hyperswine/simple-risc/docs/evidence/2026-11-07-refactor/haskell-tests.txt

Resolving dependencies...
Build profile: -w ghc-9.8.2 -O1
In order, the following will be built (use -v for more details):
 - simple-risc-0.1.0.0 (lib) (configuration changed)
 - simple-risc-0.1.0.0 (test:simple-risc-test) (configuration changed)
Configuring library for simple-risc-0.1.0.0...
Preprocessing library for simple-risc-0.1.0.0...
Building library for simple-risc-0.1.0.0...
[4 of 9] Compiling SimpleRisc.Decode ( src/SimpleRisc/Decode.hs, dist-newstyle/build/aarch64-osx/ghc-9.8.2/simple-risc-0.1.0.0/build/SimpleRisc/Decode.o, dist-newstyle/build/aarch64-osx/ghc-9.8.2/simple-risc-0.1.0.0/build/SimpleRisc/Decode.dyn_o ) [Source file changed]
[6 of 9] Compiling SimpleRisc       ( src/SimpleRisc.hs, dist-newstyle/build/aarch64-osx/ghc-9.8.2/simple-risc-0.1.0.0/build/SimpleRisc.o, dist-newstyle/build/aarch64-osx/ghc-9.8.2/simple-risc-0.1.0.0/build/SimpleRisc.dyn_o ) [Source file changed]

src/SimpleRisc.hs:557:16: warning: [GHC-30606] [-Wredundant-constraints]
    Redundant constraint: 1 <= n
    In the type signature for:
         initialFifo :: forall (n :: Nat).
                        (KnownNat n, KnownNat (n + 1), 1 <= n) =>
                        Fifo n
    |
557 | initialFifo :: (KnownNat n, KnownNat (n + 1), 1 <= n) => Fifo n
    |                ^^^^^^^^^^^^^^^^^^^^^^^^^^^^^^^^^^^^^^

src/SimpleRisc.hs:674:13: warning: [GHC-63397] [-Wname-shadowing]
    This binding for ‘at’ shadows the existing binding
      imported from ‘Clash.Prelude’ at src/SimpleRisc.hs:80:1-20
      (and originally defined in ‘Clash.Sized.Vector’)
    |
674 |     writing at = case taken of
    |             ^^

src/SimpleRisc.hs:2570:7: warning: [GHC-40910] [-Wunused-local-binds]
    Defined but not used: ‘instruction’
     |
2570 |   let instruction = cpuInstruction machine
     |       ^^^^^^^^^^^
[7 of 9] Compiling SdramSimpleRisc  ( src/SdramSimpleRisc.hs, dist-newstyle/build/aarch64-osx/ghc-9.8.2/simple-risc-0.1.0.0/build/SdramSimpleRisc.o, dist-newstyle/build/aarch64-osx/ghc-9.8.2/simple-risc-0.1.0.0/build/SdramSimpleRisc.dyn_o ) [SimpleRisc changed]
[8 of 9] Compiling SdramPipeline    ( src/SdramPipeline.hs, dist-newstyle/build/aarch64-osx/ghc-9.8.2/simple-risc-0.1.0.0/build/SdramPipeline.o, dist-newstyle/build/aarch64-osx/ghc-9.8.2/simple-risc-0.1.0.0/build/SdramPipeline.dyn_o ) [SimpleRisc changed]

src/SdramPipeline.hs:83:14: warning: [GHC-40910] [-Wunused-local-binds]
    Defined but not used: ‘index’
   |
83 |       (next,(index,write,tx),stages,loads)=R.machineStepCoreStagesBy R.pipelinedCpuStepStages decodeTarget injected (memoryWord,received,txReady,emergency)
   |              ^^^^^

src/SdramPipeline.hs:119:10: warning: [GHC-63397] [-Wname-shadowing]
    This binding for ‘at’ shadows the existing binding
      imported from ‘Clash.Prelude’ at src/SdramPipeline.hs:4:1-20
      (and originally defined in ‘Clash.Sized.Vector’)
    |
119 |  writing at=case taken of
    |          ^^
[9 of 9] Compiling SdramPipelineObserved ( src/SdramPipelineObserved.hs, dist-newstyle/build/aarch64-osx/ghc-9.8.2/simple-risc-0.1.0.0/build/SdramPipelineObserved.o, dist-newstyle/build/aarch64-osx/ghc-9.8.2/simple-risc-0.1.0.0/build/SdramPipelineObserved.dyn_o ) [SimpleRisc changed]
Configuring test suite 'simple-risc-test' for simple-risc-0.1.0.0...
Preprocessing test suite 'simple-risc-test' for simple-risc-0.1.0.0...
Building test suite 'simple-risc-test' for simple-risc-0.1.0.0...
[1 of 5] Compiling FQueueVariant    ( test/FQueueVariant.hs, dist-newstyle/build/aarch64-osx/ghc-9.8.2/simple-risc-0.1.0.0/t/simple-risc-test/build/simple-risc-test/simple-risc-test-tmp/FQueueVariant.o ) [SimpleRisc changed]

test/FQueueVariant.hs:25:2: warning: [GHC-63397] [-Wname-shadowing]
    This binding for ‘empty’ shadows the existing binding
      imported from ‘Clash.Prelude’ at test/FQueueVariant.hs:7:1-20
      (and originally defined in ‘GHC.Base’)
   |
25 |  empty = R.Fetched 0 0 False False 0 0 4
   |  ^^^^^
[4 of 5] Compiling SimpleRisc       ( test/SimpleRisc.hs, dist-newstyle/build/aarch64-osx/ghc-9.8.2/simple-risc-0.1.0.0/t/simple-risc-test/build/simple-risc-test/simple-risc-test-tmp/SimpleRisc.o ) [Source file changed]

test/SimpleRisc.hs:1032:7: warning: [GHC-63397] [-Wname-shadowing]
    This binding for ‘settled’ shadows the existing binding
      defined at test/SimpleRisc.hs:107:1
     |
1032 |       settled = stepDevices False False NoEffect (stepDevices False False NoEffect devices)
     |       ^^^^^^^

test/SimpleRisc.hs:1066:3: warning: [GHC-63397] [-Wname-shadowing]
    This binding for ‘delay’ shadows the existing binding
      imported from ‘Clash.Prelude’ at test/SimpleRisc.hs:17:1-38
      (and originally defined in ‘Clash.Signal’)
     |
1066 |   delay <- forAll (Gen.integral (Range.linear 200 400))
     |   ^^^^^

test/SimpleRisc.hs:1112:18: warning: [GHC-63394] [-Wx-partial]
    In the use of ‘head’
    (imported from Prelude, but defined in GHC.List):
    "This is a partial function, it throws an error on empty lists. Use pattern matching or Data.List.uncons instead. Consider refactoring to use Data.List.NonEmpty."
     |
1112 |       fetching = P.head (P.dropWhile ((/= Fetch) . cpuPhase) (P.iterate step m))
     |                  ^^^^^^

test/SimpleRisc.hs:1118:21: warning: [GHC-63394] [-Wx-partial]
    In the use of ‘head’
    (imported from Prelude, but defined in GHC.List):
    "This is a partial function, it throws an error on empty lists. Use pattern matching or Data.List.uncons instead. Consider refactoring to use Data.List.NonEmpty."
     |
1118 |       let entered = P.head (P.dropWhile ((== Trap) . cpuPhase) (P.iterate step next))
     |                     ^^^^^^

test/SimpleRisc.hs:1152:15: warning: [GHC-63397] [-Wname-shadowing]
    This binding for ‘at’ shadows the existing binding
      imported from ‘Clash.Prelude’ at test/SimpleRisc.hs:17:1-38
      (and originally defined in ‘Clash.Sized.Vector’)
     |
1152 |   let request at wr value = Just (BusRequest (ioBase+at) 2 wr value)
     |               ^^

test/SimpleRisc.hs:1153:25: warning: [GHC-63397] [-Wname-shadowing]
    This binding for ‘reset’ shadows the existing binding
      bound at test/SimpleRisc.hs:1159:7
     |
1153 |       clock io req held reset = fst (SP.spiIoStep io (req,reset,held,high))
     |                         ^^^^^

test/SimpleRisc.hs:1184:15: warning: [GHC-63397] [-Wname-shadowing]
    This binding for ‘rises’ shadows the existing binding
      bound at test/SimpleRisc.hs:1194:20
     |
1184 |       run spi rises sent fuel
     |               ^^^^^

test/SimpleRisc.hs:1184:21: warning: [GHC-63397] [-Wname-shadowing]
    This binding for ‘sent’ shadows the existing binding
      bound at test/SimpleRisc.hs:1194:14
     |
1184 |       run spi rises sent fuel
     |                     ^^^^

test/SimpleRisc.hs:1245:23: warning: [GHC-40910] [-Wunused-local-binds]
    Defined but not used: ‘sck’
     |
1245 |       (io', (answer, (sck, mosi, _), ramCommand)) = ioStep io (request, False, misoBit, rigRamOut rig)
     |                       ^^^

test/SimpleRisc.hs:1300:16: warning: [GHC-63394] [-Wx-partial]
    In the use of ‘head’
    (imported from Prelude, but defined in GHC.List):
    "This is a partial function, it throws an error on empty lists. Use pattern matching or Data.List.uncons instead. Consider refactoring to use Data.List.NonEmpty."
     |
1300 |       status = P.head (rigAnswers (rigAccess ioDmaStatus False 0 received))
     |                ^^^^^^

test/SimpleRisc.hs:1310:17: warning: [GHC-63394] [-Wx-partial]
    In the use of ‘head’
    (imported from Prelude, but defined in GHC.List):
    "This is a partial function, it throws an error on empty lists. Use pattern matching or Data.List.uncons instead. Consider refactoring to use Data.List.NonEmpty."
     |
1310 |       refusal = P.head (rigAnswers (rigAccess ioDmaStatus False 0 refused))
     |                 ^^^^^^

test/SimpleRisc.hs:1324:19: warning: [GHC-63397] [-Wname-shadowing]
    This binding for ‘io’ shadows the existing binding
      bound at test/SimpleRisc.hs:1331:17
     |
1324 |       go fuel sim io
     |                   ^^

test/SimpleRisc.hs:1385:16: warning: [GHC-63397] [-Wname-shadowing]
    This binding for ‘odd’ shadows the existing binding
      imported from ‘Clash.Prelude’ at test/SimpleRisc.hs:17:1-38
      (and originally defined in ‘Clash.Class.Parity’)
     |
1385 |     (8, (\f3 k odd rs1 rs2 -> [bType (4 * k + (if odd then 2 else 0)) rs2 rs1 f3 0])
     |                ^^^

test/SimpleRisc.hs:1391:13: warning: [GHC-63397] [-Wname-shadowing]
    This binding for ‘odd’ shadows the existing binding
      imported from ‘Clash.Prelude’ at test/SimpleRisc.hs:17:1-38
      (and originally defined in ‘Clash.Class.Parity’)
     |
1391 |     (3, (\k odd rd -> [(9 `shiftL` 7) .|. 0x17, iType (4 * (k + 1) + (if odd then 2 else 0)) 9 0 rd 0x67])
     |             ^^^

test/SimpleRisc.hs:1407:5: warning: [GHC-63397] [-Wname-shadowing]
    This binding for ‘forward’ shadows the existing binding
      imported from ‘Clash.Prelude’ at test/SimpleRisc.hs:17:1-38
      (and originally defined in ‘Clash.Signal.Delayed.Internal’)
     |
1407 |     forward = Gen.integral (Range.linear 1 remaining)
     |     ^^^^^^^

test/SimpleRisc.hs:1426:18: warning: [GHC-63397] [-Wname-shadowing]
    This binding for ‘at’ shadows the existing binding
      imported from ‘Clash.Prelude’ at test/SimpleRisc.hs:17:1-38
      (and originally defined in ‘Clash.Sized.Vector’)
     |
1426 |             from at c = do
     |                  ^^

test/SimpleRisc.hs:1482:21: warning: [GHC-18042] [-Wtype-defaults]
    • Defaulting the type variable ‘a0’ to type ‘Integer’ in the following constraints
        (Num a0) arising from the literal ‘1’ at test/SimpleRisc.hs:1482:21
        (Enum a0)
          arising from the arithmetic sequence ‘1 .. 8’
          at test/SimpleRisc.hs:1482:20-27
        (Integral a0)
          arising from a use of ‘fromIntegral’
          at test/SimpleRisc.hs:1485:58-69
        (Integral a0)
          arising from a use of ‘fromIntegral’
          at test/SimpleRisc.hs:1490:80-91
    • In the expression: 1
      In the first argument of ‘P.zip’, namely ‘[1 .. 8]’
      In the first argument of ‘(P.++)’, namely ‘P.zip [1 .. 8] values’
     |
1482 |   let regs = P.zip [1 .. 8] values P.++ [(31, dataPointer)]
     |                     ^

test/SimpleRisc.hs:1543:21: warning: [GHC-18042] [-Wtype-defaults]
    • Defaulting the type variable ‘a0’ to type ‘Integer’ in the following constraints
        (Num a0) arising from the literal ‘1’ at test/SimpleRisc.hs:1543:21
        (Enum a0)
          arising from the arithmetic sequence ‘1 .. 8’
          at test/SimpleRisc.hs:1543:20-27
        (Integral a0)
          arising from a use of ‘fromIntegral’
          at test/SimpleRisc.hs:1545:53-64
    • In the expression: 1
      In the first argument of ‘P.zip’, namely ‘[1 .. 8]’
      In the first argument of ‘(P.++)’, namely ‘P.zip [1 .. 8] values’
     |
1543 |       regs = P.zip [1 .. 8] values P.++ [(31, dataPointer)]
     |                     ^

test/SimpleRisc.hs:1547:15: warning: [GHC-63397] [-Wname-shadowing]
    This binding for ‘cycle’ shadows the existing binding
      imported from ‘Clash.Prelude’ at test/SimpleRisc.hs:17:1-38
      (and originally defined in ‘GHC.List’)
     |
1547 |       run sim cycle pending
     |               ^^^^^

test/SimpleRisc.hs:1556:7: warning: [GHC-63397] [-Wname-shadowing]
    This binding for ‘quiet’ shadows the existing binding
      defined at test/SimpleRisc.hs:165:1
     |
1556 |       quiet = finish (run start (0 :: Int) [])
     |       ^^^^^

test/SimpleRisc.hs:2083:7: warning: [GHC-63397] [-Wname-shadowing]
    This binding for ‘at’ shadows the existing binding
      imported from ‘Clash.Prelude’ at test/SimpleRisc.hs:17:1-38
      (and originally defined in ‘Clash.Sized.Vector’)
     |
2083 |       at l = IntMap.findWithDefault 0 l labels
     |       ^^

test/SimpleRisc.hs:2134:18: warning: [GHC-63397] [-Wname-shadowing]
    This binding for ‘items’ shadows the existing binding
      bound at test/SimpleRisc.hs:2144:11
     |
2134 |         let (n', items) = cflowFlatten i n body
     |                  ^^^^^

test/SimpleRisc.hs:2157:11: warning: [GHC-63397] [-Wname-shadowing]
    This binding for ‘pipelined’ shadows the existing binding
      defined at test/SimpleRisc.hs:1475:1
     |
2157 |       run pipelined = runUntilHalt 120000 (startSim ((runningMachine regs) {cpuCompressed = True, cpuPipelined = pipelined}) (ramFromHalfwords halves))
     |           ^^^^^^^^^

test/SimpleRisc.hs:2183:7: warning: [GHC-63397] [-Wname-shadowing]
    This binding for ‘check’ shadows the existing binding
      imported from ‘Hedgehog’ at test/SimpleRisc.hs:21:1-15
      (and originally defined in ‘Hedgehog.Internal.Runner’)
     |
2183 |   let check (size, raw, word) =
     |       ^^^^^

test/SimpleRisc.hs:2193:7: warning: [GHC-63397] [-Wname-shadowing]
    This binding for ‘words’ shadows the existing binding
      imported from ‘Clash.Prelude’ at test/SimpleRisc.hs:17:1-38
      (and originally defined in ‘base-4.19.1.0:Data.OldList’)
     |
2193 |   let words = [ (imm `shiftL` 20) .|. (rs1 `shiftL` 15) .|. (rd `shiftL` 7) .|. op
     |       ^^^^^

test/SimpleRisc.hs:2201:13: warning: [GHC-63397] [-Wname-shadowing]
    This binding for ‘pipelined’ shadows the existing binding
      defined at test/SimpleRisc.hs:1475:1
     |
2201 |   P.mapM_ (\pipelined -> do
     |             ^^^^^^^^^

test/SimpleRisc.hs:2220:13: warning: [GHC-63397] [-Wname-shadowing]
    This binding for ‘pipelined’ shadows the existing binding
      defined at test/SimpleRisc.hs:1475:1
     |
2220 |   P.mapM_ (\pipelined -> do
     |             ^^^^^^^^^

test/SimpleRisc.hs:2235:13: warning: [GHC-63397] [-Wname-shadowing]
    This binding for ‘pipelined’ shadows the existing binding
      defined at test/SimpleRisc.hs:1475:1
     |
2235 |   P.mapM_ (\pipelined -> do
     |             ^^^^^^^^^

test/SimpleRisc.hs:2256:13: warning: [GHC-63397] [-Wname-shadowing]
    This binding for ‘pipelined’ shadows the existing binding
      defined at test/SimpleRisc.hs:1475:1
     |
2256 |   P.mapM_ (\pipelined -> do
     |             ^^^^^^^^^

test/SimpleRisc.hs:2278:13: warning: [GHC-63397] [-Wname-shadowing]
    This binding for ‘pipelined’ shadows the existing binding
      defined at test/SimpleRisc.hs:1475:1
     |
2278 |   P.mapM_ (\pipelined -> do
     |             ^^^^^^^^^

test/SimpleRisc.hs:2465:7: warning: [GHC-63397] [-Wname-shadowing]
    This binding for ‘empty’ shadows the existing binding
      imported from ‘Clash.Prelude’ at test/SimpleRisc.hs:17:1-38
      (and originally defined in ‘GHC.Base’)
     |
2465 |   let empty = Fetched 0 0 False False 0 0 4
     |       ^^^^^

test/SimpleRisc.hs:2491:32: warning: [GHC-18042] [-Wtype-defaults]
    • Defaulting the type variable ‘i0’ to type ‘Integer’ in the following constraints
        (Enum i0)
          arising from a use of ‘!!’ at test/SimpleRisc.hs:2491:32-33
        (Num i0)
          arising from a use of ‘toggle’ at test/SimpleRisc.hs:2491:35-40
    • In the expression: table !! toggle r
      In the expression: [table !! r, table !! toggle r]
      In a case alternative: _ -> [table !! r, table !! toggle r]
     |
2491 |         _ -> [table !! r,table !! toggle r]
     |                                ^^
[5 of 5] Compiling Main             ( test/Spec.hs, dist-newstyle/build/aarch64-osx/ghc-9.8.2/simple-risc-0.1.0.0/t/simple-risc-test/build/simple-risc-test/simple-risc-test-tmp/Main.o ) [SimpleRisc changed]
[6 of 6] Linking dist-newstyle/build/aarch64-osx/ghc-9.8.2/simple-risc-0.1.0.0/t/simple-risc-test/build/simple-risc-test/simple-risc-test [Objects changed]
ld: warning: -U option is redundant when using -undefined dynamic_lookup
Running 1 test suites...
Test suite simple-risc-test: RUNNING...
━━━ SimpleRisc ━━━
  ✓ Experimental F queue banks preserve owned payloads through holds and cancellation passed 200 tests.
  ✓ Separate BTB storage preserves effective reads through repeated holds passed 200 tests.
  ✓ Frontend assembly, expansion and register reads have separate boundaries passed 300 tests.
  ✓ Compressed BTB predicts halfword branches and recovers from straddle aliases passed 1 test.
  ✓ Compressed control flow matches the multi-cycle core passed 300 tests.
    a straddling 32-bit instruction      77% ███████████████▎····
    five or more straddling instructions 44% ████████▊···········
  ✓ Raw assembly-stage control classes match the expanded words passed 1 test.
  ✓ Registered decode hazards match arriving producer stages passed 200 tests.
  ✓ Compressed mret and FENCE.I discard stale halfwords passed 1 test.
  ✓ Compressed ALU stream matches independent RV32 interpreter passed 200 tests.
  ✓ Compressed pipeline retains straight-line instruction throughput passed 1 test.
  ✓ Compressed mixed fetch, stores and pc+2 links passed 1 test.
  ✓ Compressed hints and precise raw illegal traps passed 1 test.
  ✓ Compressed boundary fetch and mepc IALIGN16 passed 1 test.
  ✓ Bus completes once and preserves concurrent RX passed 100 tests.
  ✓ Bus waits, precise faults and cancellation passed 100 tests.
  ✓ Registered memory target selection passed 100 tests.
  ✓ Finisher exits reset into the ROM; BOOTCAUSE reads and clears passed 100 tests.
  ✓ Split counters match a 64-bit reference passed 100 tests.
  ✓ Counter CSR reads wait for carry passed 100 tests.
  ✓ Precise retirement and UART stalls passed 1 test.
  ✓ Counter writes override implicit increments passed 1 test.
  ✓ All six CSR read/modify/write forms passed 100 tests.
  ✓ CSR access rules and WARL masks passed 100 tests.
  ✓ Guest trap handler resumes with mret passed 1 test.
  ✓ MRET restores machine status passed 100 tests.
  ✓ mtip compares all 64 bits passed 100 tests.
  ✓ Timer interrupt wakes WFI passed 100 tests.
  ✓ UART interrupt claims through the PLIC passed 100 tests.
  ✓ Reset quietens interrupt sources passed 1 test.
  ✓ SPI exchanges bytes in mode 0 passed 100 tests.
  ✓ SDRAM SPI survives cache holds passed 1 test.
  ✓ FIFO is a bounded queue passed 100 tests.
  ✓ A program reaches the I/O complex passed 1 test.
  ✓ SPI DMA moves blocks passed 100 tests.
  ✓ Core matches the reference model on random programs passed 300 tests.
    ends in ECALL                  84% ████████████████▊···
    ends in an illegal instruction  6% █▏··················
    ends in a misaligned access     4% ▊···················
    ends in an access fault         1% ▏···················
    ends in a misaligned jump       3% ▌···················
    jumps into the ROM              0% ····················
    retires 30 or more             22% ████▎···············
    takes a software interrupt     17% ███▎················
    runs a loop                    34% ██████▋·············
  ✓ Pipeline matches the reference model on random programs passed 300 tests.
    ends in ECALL                  84% ████████████████▊···
    ends in an illegal instruction  6% █▏··················
    ends in a misaligned access     4% ▊···················
    ends in an access fault         1% ▏···················
    ends in a misaligned jump       3% ▌···················
    jumps into the ROM              0% ····················
    retires 30 or more             22% ████▎···············
    takes a software interrupt     17% ███▎················
    runs a loop                    34% ██████▋·············
  ✓ The pipeline's multiplier is exact passed 2000 tests.
  ✓ Chained ALU/LUI/AUIPC dependencies forward from E2 passed 1 test.
  ✓ Interrupts are transparent to the phases passed 100 tests.
    interrupted 100% ████████████████████
  ✓ Interrupts are transparent to the pipeline passed 100 tests.
    interrupted 100% ████████████████████
  ✓ MRET takes a pending interrupt at once passed 100 tests.
  ✓ Boot ROM quietens interrupt sources before R passed 1 test.
  ✓ Precise staged exception entry passed 100 tests.
  ✓ Unhandled traps return to the boot ROM; Ctrl-C resets passed 1 test.
  ✓ Faulting store never writes RAM passed 1 test.
  ✓ Every register bank and x0 survives decode/writeback passed 100 tests.
  ✓ RV32I arithmetic result reaches BRAM passed 100 tests.
  ✓ Boot ROM loads programs with a guard word passed 20 tests.
  ✓ Boot ROM implements Base T/Q/V/H commands passed 1 test.
  ✓ Boot ROM implements SRID1 I and SRU1 U/C/G commands passed 1 test.
  ✓ Boot ROM clears RAM passed 1 test.
  ✓ RV32M matches the reference semantics passed 400 tests.
  ✓ Pipeline M operations use the correct service passed 100 tests.
  ✓ Division-only service preserves results and latency passed 400 tests.
  ✓ Test encoders match known instructions passed 1 test.
  ✓ Backward branch in final word loops passed 100 tests.
  ✓ SDRAM holds full word addresses across waits passed 100 tests.
  ✓ SDRAM map and boot ROM reads passed 1 test.
  ✓ SDRAM reset drains pending memory passed 1 test.
  ✓ Registered CSR selection matches reference passed 100 tests.
  ✓ Registered execution matches compute passed 100 tests.
  ✓ Split comparisons match signed/unsigned references passed 100 tests.
  ✓ Simple instructions overlap unless dependent passed 100 tests.
  ✓ Two-stage shifts cover every distance passed 1 test.
  ✓ Pipelined shifts forward from E2 passed 1 test.
  ✓ Store into next instruction is fetched fresh passed 1 test.
  ✓ MISC-MEM decoding passed 1 test.
  ✓ RAM accesses take the fast path passed 100 tests.
  ✓ A taken jump fetches its target early passed 1 test.
  ✓ UART TX store waits for ready passed 100 tests.
  ✓ Circuit programs and runs over UART passed 1 test.
  ✓ UART TX timing and byte latch passed 100 tests.
  ✓ UART RX 8-N-1 sampling passed 100 tests.
  ✓ UART RX holding register passed 100 tests.
  ✓ 74 succeeded.
━━━ PsramRegs ━━━
  ✓ boot passed 1 test.
  ✓ matches the psram_regs.ino model passed 40 tests.
  ✓ write-through and flush passed 1 test.
  ✓ verify failure sets ERR passed 1 test.
  ✓ stale partial frame dropped passed 1 test.
  ✓ lost messages reported passed 1 test.
  ✓ UART end to end passed 1 test.
  ✓ UART burst keeps snapshots whole passed 1 test.
  ✓ 8 succeeded.
Test suite simple-risc-test: PASS
Test suite logged to:
/Users/jasonqin/Documents/GitHub/simple-risc/./dist-newstyle/build/aarch64-osx/ghc-9.8.2/simple-risc-0.1.0.0/t/simple-risc-test/test/simple-risc-0.1.0.0-simple-risc-test.log
1 of 1 test suites (1 of 1 test cases) passed.
/Users/jasonqin/.cache/cabal/logs/build.log: withFile: permission denied (Operation not permitted)
