hyperswine/simple-risc/docs/evidence/2026-11-08-a-to-f/baseline-p4/sdram_test.rpt.txt

//Copyright (C)2014-2026 Gowin Semiconductor Corporation.
//All rights reserved.

1. PnR Messages

  <Report Title>: PnR Report
  <Design File>: /Users/jasonqin/Documents/GitHub/simple-risc/output/btb-floorplan-2026-11-08/baseline-t89-source/impl/gwsynthesis/sdram_test.vg
  <Physical Constraints File>: /Users/jasonqin/Documents/GitHub/simple-risc/output/btb-floorplan-2026-11-08/baseline-t89-p4/pins.cst
  <Timing Constraints File>: /Users/jasonqin/Documents/GitHub/simple-risc/output/btb-floorplan-2026-11-08/baseline-t89-p4/clocks.sdc
  <Tool Version>: V1.9.12.04
  <Part Number>: GW2AR-LV18QN88C8/I7
  <Device>: GW2AR-18
  <Device Version>: C
  <Created Time>:Sun Nov  8 13:16:47 2026

2. PnR Details

  Running placement:
    Placement Phase 0: CPU time = 0h 0m 0.933s, Elapsed time = 0h 0m 0.943s
    Placement Phase 1: CPU time = 0h 0m 55s, Elapsed time = 0h 0m 56s
    Placement Phase 2: CPU time = 0h 0m 8s, Elapsed time = 0h 0m 8s
    Placement Phase 3: CPU time = 0h 0m 17s, Elapsed time = 0h 0m 18s
    Total Placement: CPU time = 0h 1m 21s, Elapsed time = 0h 1m 23s
 Running routing:
    Routing Phase 0: CPU time = 0h 0m 0.002s, Elapsed time = 0h 0m 0.002s
    Routing Phase 1: CPU time = 0h 0m 0.248s, Elapsed time = 0h 0m 0.257s
    Routing Phase 2: CPU time = 0h 8m 39s, Elapsed time = 0h 9m 3s
    Routing Phase 3: CPU time = 0h 0m 0s, Elapsed time = 0h 0m 0s
    ERROR  (PR0004) : There are total 557 unrouted nets
    Total Routing: CPU time = 0h 8m 39s, Elapsed time = 0h 9m 4s
 Generate output files:
    CPU time = 0h 0m 0s, Elapsed time = 0h 0m 0s

 Total Time and Memory Usage: CPU time = 0h 10m 0s, Elapsed time = 0h 10m 26s, Peak memory usage = 1349MB

3. Resource Usage Summary

  --------------------------------------------------------------------------------
  Resources                   | Usage                               | Utilization
  --------------------------------------------------------------------------------
  Logic                       | 15170/20736                         |  74%
    --LUT,ALU,ROM16           | 14978(13977 LUT, 1001 ALU, 0 ROM16) | -
    --SSRAM(RAM16)            | 32                                  | -
  Register                    | 5436/15915                          |  35%
    --Logic Register as Latch | 0/15552                             |  0%
    --Logic Register as FF    | 5383/15552                          |  35%
    --I/O Register as Latch   | 0/363                               |  0%
    --I/O Register as FF      | 53/363                              |  15%
  CLS                         | 8629/10368                          |  84%
  I/O Port                    | 10/66                               |  16%
  I/O Buf                     | 10                                  | -
    --Input Buf               | 4                                   | -
    --Output Buf              | 6                                   | -
    --Inout Buf               | 0                                   | -
  BSRAM                       | 40/46                               | 87%
    --SDPB                    | 37
    --SDPX9B                  | 2
    --pROM                    | 1
  DSP                         | 2.5/24                              | 11%
    --MULT18X18               | 1
    --MULTADDALU18X18         | 2
  ================================================================================

4. I/O Bank Usage Summary

  --------------------------------------
  I/O Bank  | Usage       | Utilization 
  --------------------------------------
  bank 0   | 6/8         | 75%         
  bank 1   | 2/9         | 23%         
  bank 2   | 0/4         | 0%          
  bank 3   | 1/17        | 6%          
  bank 4   | 0/8         | 0%          
  bank 5   | 0/10        | 0%          
  bank 6   | 0/9         | 0%          
  bank 7   | 1/1         | 100%        
  ======================================

5. Clock Resource Usage Summary

  ------------------------------------------
  Clock Resource| Usage         | Utilization 
  ------------------------------------------
  PRIMARY       | 5/8           | 63%
  LW            | 8/8           | 100%
  GCLK_PIN      | 1/5           | 20%
  rPLL          | 2/2           | 100%
  ==========================================

6. Global Clock Signals

  -------------------------------------------
  Signal         | Global Clock   | Location
  -------------------------------------------
  clk_27m_d      | PRIMARY        |  BR BL
  clk            | PRIMARY        |  TR TL BR BL
  clk_memory     | PRIMARY        |  TR TL BR BL
  O_sdram_clk_d  | PRIMARY        |  TR
  core/ds6_261_8 | PRIMARY        |  BL
  advance        | LW             |  -
  reset_sync[1]  | LW             |  -
  memory_reset_sync[1]| LW             |  -
  core/pipeState_8673_6| LW             |  -
  core/ds6_454_6 | LW             |  -
  core/pipeState_7674_9| LW             |  -
  core/pipeState_7541_9| LW             |  -
  core/pipeState_7270_9| LW             |  -
  ===========================================

7. Pinout by Port Name

-------------------------------------------------------------------------------------------------------------------------------------------------------------------------------------------------------------------------
Port Name         | Diff Pair | Loc./Bank     | Constraint | Dir.  | Site     | CFG             | IO Type    | Drive | Pull Mode | PCI Clamp | Hysteresis | Open Drain | Vref       | Single Resistor | Diff Resistor | BankVccio 
-------------------------------------------------------------------------------------------------------------------------------------------------------------------------------------------------------------------------
clk_27m           | -         | 4/7           | Y          | in    | IOL7[A]  | LPLL1_T_in      | LVCMOS33   | NA    | UP        | ON        | NONE       | NA         | NA         | OFF             | NA            | 3.3       
btn_s1            | -         | 88/3          | Y          | in    | IOR30[A] | MODE0           | LVCMOS33   | NA    | DOWN      | ON        | NONE       | NA         | NA         | OFF             | NA            | 3.3       
uart_rx           | -         | 70/1          | Y          | in    | IOT44[B] | -               | LVCMOS33   | NA    | UP        | ON        | NONE       | NA         | NA         | NA              | NA            | 3.3       
sd_dat0           | -         | 84/0          | Y          | in    | IOT6[A]  | -               | LVCMOS33   | NA    | UP        | ON        | NONE       | NA         | NA         | NA              | NA            | 3.3       
uart_tx           | -         | 69/1          | Y          | out   | IOT50[A] | -               | LVCMOS33   | 8     | UP        | NA        | NA         | OFF        | NA         | NA              | NA            | 3.3       
sd_clk            | -         | 83/0          | Y          | out   | IOT6[B]  | -               | LVCMOS33   | 8     | NONE      | NA        | NA         | OFF        | NA         | NA              | NA            | 3.3       
sd_cmd            | -         | 82/0          | Y          | out   | IOT17[A] | -               | LVCMOS33   | 8     | NONE      | NA        | NA         | OFF        | NA         | NA              | NA            | 3.3       
sd_dat1           | -         | 85/0          | Y          | out   | IOT4[B]  | -               | LVCMOS33   | 8     | NONE      | NA        | NA         | OFF        | NA         | NA              | NA            | 3.3       
sd_dat2           | -         | 80/0          | Y          | out   | IOT27[A] | GCLKT_0         | LVCMOS33   | 8     | NONE      | NA        | NA         | OFF        | NA         | NA              | NA            | 3.3       
sd_dat3           | -         | 81/0          | Y          | out   | IOT17[B] | -               | LVCMOS33   | 8     | NONE      | NA        | NA         | OFF        | NA         | NA              | NA            | 3.3       
O_sdram_clk       | -         | p73/2         | -          | out   | IOR11[B] | -               | LVTTL33    | -     | UP        | -         | -          | -          | -          | -               | -             | -         
O_sdram_cke       | -         | p18/7         | -          | out   | IOL13[A] | -               | LVTTL33    | -     | UP        | -         | -          | -          | -          | -               | -             | -         
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
=========================================================================================================================================================================================================================

8. All Package Pins

----------------------------------------------------------------------------------------------------------------------------------------------------------------------------------------------
Loc./Bank| Signal            | Dir.  | Site     | CFG             | IO Type  | Drive | Pull Mode | PCI Clamp | Hysteresis | Open Drain | Vref       | Single Resistor | Diff Resistor | Bank Vccio
----------------------------------------------------------------------------------------------------------------------------------------------------------------------------------------------
86/0     | -                 | in    | IOT4[A]  | -               | UNKNOWN  | NA    | UP        | ON        | NONE       | NA         | NA         | NA              | NA            | 3.3  
85/0     | sd_dat1           | out   | IOT4[B]  | -               | LVCMOS33 | 8     | NONE      | NA        | NA         | OFF        | NA         | NA              | NA            | 3.3  
84/0     | sd_dat0           | in    | IOT6[A]  | -               | LVCMOS33 | NA    | UP        | ON        | NONE       | NA         | NA         | NA              | NA            | 3.3  
83/0     | sd_clk            | out   | IOT6[B]  | -               | LVCMOS33 | 8     | NONE      | NA        | NA         | OFF        | NA         | NA              | NA            | 3.3  
82/0     | sd_cmd            | out   | IOT17[A] | -               | LVCMOS33 | 8     | NONE      | NA        | NA         | OFF        | NA         | NA              | NA            | 3.3  
81/0     | sd_dat3           | out   | IOT17[B] | -               | LVCMOS33 | 8     | NONE      | NA        | NA         | OFF        | NA         | NA              | NA            | 3.3  
80/0     | sd_dat2           | out   | IOT27[A] | GCLKT_0         | LVCMOS33 | 8     | NONE      | NA        | NA         | OFF        | NA         | NA              | NA            | 3.3  
79/0     | -                 | in    | IOT27[B] | GCLKC_0         | UNKNOWN  | NA    | UP        | ON        | NONE       | NA         | NA         | NA              | NA            | 3.3  
77/1     | -                 | in    | IOT30[A] | GCLKT_1         | UNKNOWN  | NA    | UP        | ON        | NONE       | NA         | NA         | NA              | NA            | 3.3  
76/1     | -                 | in    | IOT30[B] | GCLKC_1         | UNKNOWN  | NA    | UP        | ON        | NONE       | NA         | NA         | NA              | NA            | 3.3  
75/1     | -                 | in    | IOT34[A] | -               | UNKNOWN  | NA    | UP        | ON        | NONE       | NA         | NA         | NA              | NA            | 3.3  
74/1     | -                 | in    | IOT34[B] | -               | UNKNOWN  | NA    | UP        | ON        | NONE       | NA         | NA         | NA              | NA            | 3.3  
73/1     | -                 | in    | IOT40[A] | -               | UNKNOWN  | NA    | UP        | ON        | NONE       | NA         | NA         | NA              | NA            | 3.3  
72/1     | -                 | in    | IOT40[B] | -               | UNKNOWN  | NA    | UP        | ON        | NONE       | NA         | NA         | NA              | NA            | 3.3  
71/1     | -                 | in    | IOT44[A] | -               | UNKNOWN  | NA    | UP        | ON        | NONE       | NA         | NA         | NA              | NA            | 3.3  
70/1     | uart_rx           | in    | IOT44[B] | -               | LVCMOS33 | NA    | UP        | ON        | NONE       | NA         | NA         | NA              | NA            | 3.3  
69/1     | uart_tx           | out   | IOT50[A] | -               | LVCMOS33 | 8     | UP        | NA        | NA         | OFF        | NA         | NA              | NA            | 3.3  
----------------------------------------------------------------------------------------------------------------------------------------------------------------------------------------------
25/5     | -                 | in    | IOB6[A]  | -               | UNKNOWN  | NA    | UP        | ON        | NONE       | NA         | NA         | NA              | NA            | 1.8  
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
8/2      | -                 | out   | IOR25[A] | TDO             | UNKNOWN  | 8     | UP        | NA        | NA         | OFF        | NA         | NA              | NA            | 3.3  
5/2      | -                 | in    | IOR25[B] | TMS             | UNKNOWN  | NA    | UP        | ON        | NONE       | NA         | NA         | NA              | NA            | 3.3  
6/2      | -                 | in    | IOR26[A] | TCK             | UNKNOWN  | NA    | UP        | ON        | NONE       | NA         | NA         | NA              | NA            | 3.3  
7/2      | -                 | in    | IOR26[B] | TDI             | UNKNOWN  | NA    | UP        | ON        | NONE       | NA         | NA         | NA              | NA            | 3.3  
63/3     | -                 | in    | IOR29[A] | GCLKT_3         | UNKNOWN  | NA    | UP        | ON        | NONE       | NA         | NA         | NA              | NA            | 3.3  
88/3     | btn_s1            | in    | IOR30[A] | MODE0           | LVCMOS33 | NA    | DOWN      | ON        | NONE       | NA         | NA         | OFF             | NA            | 3.3  
87/3     | -                 | in    | IOR30[B] | MODE1           | UNKNOWN  | NA    | UP        | ON        | NONE       | NA         | NA         | NA              | NA            | 3.3  
9/3      | -                 | in    | IOR31[B] | RECONFIG_N      | UNKNOWN  | NA    | UP        | ON        | NONE       | NA         | NA         | NA              | NA            | 3.3  
62/3     | -                 | in    | IOR33[A] | MI/D7           | UNKNOWN  | NA    | UP        | ON        | NONE       | NA         | NA         | NA              | NA            | 3.3  
61/3     | -                 | in    | IOR33[B] | MO/D6           | UNKNOWN  | NA    | UP        | ON        | NONE       | NA         | NA         | NA              | NA            | 3.3  
60/3     | -                 | in    | IOR34[A] | MCS_N/D5        | UNKNOWN  | NA    | UP        | ON        | NONE       | NA         | NA         | NA              | NA            | 3.3  
59/3     | -                 | in    | IOR34[B] | MCLK/D4         | UNKNOWN  | NA    | UP        | ON        | NONE       | NA         | NA         | NA              | NA            | 3.3  
57/3     | -                 | in    | IOR35[A] | FASTRD_N/D3     | UNKNOWN  | NA    | UP        | ON        | NONE       | NA         | NA         | NA              | NA            | 3.3  
56/3     | -                 | in    | IOR36[A] | SO/D1           | UNKNOWN  | NA    | UP        | ON        | NONE       | NA         | NA         | NA              | NA            | 3.3  
55/3     | -                 | in    | IOR36[B] | SSPI_CS_N/D0    | UNKNOWN  | NA    | UP        | ON        | NONE       | NA         | NA         | NA              | NA            | 3.3  
54/3     | -                 | in    | IOR38[A] | DIN/CLKHOLD_N   | UNKNOWN  | NA    | UP        | ON        | NONE       | NA         | NA         | NA              | NA            | 3.3  
53/3     | -                 | in    | IOR38[B] | DOUT/WE_N       | UNKNOWN  | NA    | UP        | ON        | NONE       | NA         | NA         | NA              | NA            | 3.3  
52/3     | -                 | in    | IOR39[A] | SCLK            | UNKNOWN  | NA    | UP        | ON        | NONE       | NA         | NA         | NA              | NA            | 3.3  
p49/3    | IO_sdram_dq[30]   | io    | IOR44[A] | -               | LVTTL33  | -     | UP        | -         | -          | -          | -          | -               | -             | -    
p48/3    | IO_sdram_dq[31]   | io    | IOR44[B] | -               | LVTTL33  | -     | UP        | -         | -          | -          | -          | -               | -             | -    
51/3     | -                 | in    | IOR45[A] | RPLL2_T_in      | UNKNOWN  | NA    | UP        | ON        | NONE       | NA         | NA         | NA              | NA            | 3.3  
49/3     | -                 | in    | IOR49[A] | -               | UNKNOWN  | NA    | UP        | ON        | NONE       | NA         | NA         | NA              | NA            | 3.3  
48/3     | -                 | in    | IOR49[B] | -               | UNKNOWN  | NA    | UP        | ON        | NONE       | NA         | NA         | NA              | NA            | 3.3  
----------------------------------------------------------------------------------------------------------------------------------------------------------------------------------------------
==============================================================================================================================================================================================
