hyperswine/simple-risc/docs/evidence/2026-11-08-a-to-f/candidate-p0/sdram_test.rpt.txt

//Copyright (C)2014-2026 Gowin Semiconductor Corporation.
//All rights reserved.

1. PnR Messages

  <Report Title>: PnR Report
  <Design File>: /Users/jasonqin/Documents/GitHub/simple-risc/output/a-to-f-2026-11-08/candidate-physical/impl/gwsynthesis/sdram_test.vg
  <Physical Constraints File>: /Users/jasonqin/Documents/GitHub/simple-risc/output/a-to-f-2026-11-08/candidate-p0/pins.cst
  <Timing Constraints File>: /Users/jasonqin/Documents/GitHub/simple-risc/output/a-to-f-2026-11-08/candidate-p0/clocks.sdc
  <Tool Version>: V1.9.12.04
  <Part Number>: GW2AR-LV18QN88C8/I7
  <Device>: GW2AR-18
  <Device Version>: C
  <Created Time>:Sun Nov  8 19:16:11 2026

2. PnR Details

  Running placement:
    Placement Phase 0: CPU time = 0h 0m 0.942s, Elapsed time = 0h 0m 0.964s
    Placement Phase 1: CPU time = 0h 0m 0.386s, Elapsed time = 0h 0m 0.397s
    Placement Phase 2: CPU time = 0h 0m 6s, Elapsed time = 0h 0m 6s
    Placement Phase 3: CPU time = 0h 0m 7s, Elapsed time = 0h 0m 7s
    Total Placement: CPU time = 0h 0m 14s, Elapsed time = 0h 0m 14s
 Running routing:
    Routing Phase 0: CPU time = 0h 0m 0.002s, Elapsed time = 0h 0m 0.002s
    Routing Phase 1: CPU time = 0h 0m 0.239s, Elapsed time = 0h 0m 0.247s
    Routing Phase 2: CPU time = 0h 13m 11s, Elapsed time = 0h 13m 42s
    Routing Phase 3: CPU time = 0h 0m 0s, Elapsed time = 0h 0m 0s
    Total Routing: CPU time = 0h 13m 11s, Elapsed time = 0h 13m 42s
 Generate output files:
    CPU time = 0h 0m 0.841s, Elapsed time = 0h 0m 0.845s

 Total Time and Memory Usage: CPU time = 0h 13m 26s, Elapsed time = 0h 13m 57s, Peak memory usage = 501MB

3. Resource Usage Summary

  --------------------------------------------------------------------------------
  Resources                   | Usage                               | Utilization
  --------------------------------------------------------------------------------
  Logic                       | 14968/20736                         |  73%
    --LUT,ALU,ROM16           | 14776(13776 LUT, 1000 ALU, 0 ROM16) | -
    --SSRAM(RAM16)            | 32                                  | -
  Register                    | 5436/15915                          |  35%
    --Logic Register as Latch | 0/15552                             |  0%
    --Logic Register as FF    | 5383/15552                          |  35%
    --I/O Register as Latch   | 0/363                               |  0%
    --I/O Register as FF      | 53/363                              |  15%
  CLS                         | 8866/10368                          |  86%
  I/O Port                    | 10/66                               |  16%
  I/O Buf                     | 10                                  | -
    --Input Buf               | 4                                   | -
    --Output Buf              | 6                                   | -
    --Inout Buf               | 0                                   | -
  BSRAM                       | 40/46                               | 87%
    --SDPB                    | 37
    --SDPX9B                  | 2
    --pROM                    | 1
  DSP                         | 2.5/24                              | 11%
    --MULT18X18               | 1
    --MULTADDALU18X18         | 2
  ================================================================================

4. I/O Bank Usage Summary

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

5. Clock Resource Usage Summary

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

6. Global Clock Signals

  -------------------------------------------
  Signal         | Global Clock   | Location
  -------------------------------------------
  clk_27m_d      | PRIMARY        |  BR BL
  clk            | PRIMARY        |  TR TL BR BL
  clk_memory     | PRIMARY        |  TR TL BR BL
  O_sdram_clk_d  | PRIMARY        |  TR
  core/pipeState_7950_9| PRIMARY        |  TR BR BL
  advance        | LW             |  -
  reset_sync[1]  | LW             |  -
  memory_reset_sync[1]| LW             |  -
  core/pipeState_8673_6| LW             |  -
  core/result_275_2813_5| LW             |  -
  core/pipeState_8349_9| LW             |  -
  core/pipeState_8216_9| LW             |  -
  core/pipeState_8083_9| LW             |  -
  ===========================================

7. Pinout by Port Name

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

8. All Package Pins

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
