hyperswine/simple-risc/docs/evidence/2026-11-08-a-to-f/candidate-p1/sdram_test.rpt.txt

//Copyright (C)2014-2026 Gowin Semiconductor Corporation.
//All rights reserved.

1. PnR Messages

  <Report Title>: PnR Report
  <Design File>: /Users/jasonqin/Documents/GitHub/simple-risc/output/a-to-f-2026-11-08/candidate-physical/impl/gwsynthesis/sdram_test.vg
  <Physical Constraints File>: /Users/jasonqin/Documents/GitHub/simple-risc/output/a-to-f-2026-11-08/candidate-p1/pins.cst
  <Timing Constraints File>: /Users/jasonqin/Documents/GitHub/simple-risc/output/a-to-f-2026-11-08/candidate-p1/clocks.sdc
  <Tool Version>: V1.9.12.04
  <Part Number>: GW2AR-LV18QN88C8/I7
  <Device>: GW2AR-18
  <Device Version>: C
  <Created Time>:Sun Nov  8 19:05:45 2026

2. PnR Details

  Running placement:
    Placement Phase 0: CPU time = 0h 0m 0.944s, Elapsed time = 0h 0m 0.967s
    Placement Phase 1: CPU time = 0h 0m 0.388s, Elapsed time = 0h 0m 0.398s
    Placement Phase 2: CPU time = 0h 0m 6s, Elapsed time = 0h 0m 6s
    Placement Phase 3: CPU time = 0h 0m 16s, Elapsed time = 0h 0m 16s
    Total Placement: CPU time = 0h 0m 23s, Elapsed time = 0h 0m 24s
 Running routing:
    Routing Phase 0: CPU time = 0h 0m 0.003s, Elapsed time = 0h 0m 0.003s
    Routing Phase 1: CPU time = 0h 0m 0.242s, Elapsed time = 0h 0m 0.247s
    Routing Phase 2: CPU time = 0h 3m 3s, Elapsed time = 0h 3m 6s
    Routing Phase 3: CPU time = 0h 0m 0s, Elapsed time = 0h 0m 0s
    Total Routing: CPU time = 0h 3m 4s, Elapsed time = 0h 3m 7s
 Generate output files:
    CPU time = 0h 0m 0.868s, Elapsed time = 0h 0m 0.874s

 Total Time and Memory Usage: CPU time = 0h 3m 28s, Elapsed time = 0h 3m 31s, Peak memory usage = 507MB

3. Resource Usage Summary

  --------------------------------------------------------------------------------
  Resources                   | Usage                               | Utilization
  --------------------------------------------------------------------------------
  Logic                       | 14968/20736                         |  73%
    --LUT,ALU,ROM16           | 14776(13776 LUT, 1000 ALU, 0 ROM16) | -
    --SSRAM(RAM16)            | 32                                  | -
  Register                    | 5436/15915                          |  35%
    --Logic Register as Latch | 0/15552                             |  0%
    --Logic Register as FF    | 5383/15552                          |  35%
    --I/O Register as Latch   | 0/363                               |  0%
    --I/O Register as FF      | 53/363                              |  15%
  CLS                         | 8782/10368                          |  85%
  I/O Port                    | 10/66                               |  16%
  I/O Buf                     | 10                                  | -
    --Input Buf               | 4                                   | -
    --Output Buf              | 6                                   | -
    --Inout Buf               | 0                                   | -
  BSRAM                       | 40/46                               | 87%
    --SDPB                    | 37
    --SDPX9B                  | 2
    --pROM                    | 1
  DSP                         | 2.5/24                              | 11%
    --MULT18X18               | 1
    --MULTADDALU18X18         | 2
  ================================================================================

4. I/O Bank Usage Summary

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

5. Clock Resource Usage Summary

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

6. Global Clock Signals

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

7. Pinout by Port Name

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

8. All Package Pins

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
