hyperswine/simple-risc/docs/evidence/2026-11-08-btb-ablation/anchors-p4/sdram_test.rpt.txt

//Copyright (C)2014-2026 Gowin Semiconductor Corporation.
//All rights reserved.

1. PnR Messages

  <Report Title>: PnR Report
  <Design File>: /Users/jasonqin/Documents/GitHub/simple-risc/output/btb-ablation-2026-11-08/anchors-source/impl/gwsynthesis/sdram_test.vg
  <Physical Constraints File>: /Users/jasonqin/Documents/GitHub/simple-risc/output/btb-ablation-2026-11-08/anchors-p4/pins.cst
  <Timing Constraints File>: /Users/jasonqin/Documents/GitHub/simple-risc/output/btb-ablation-2026-11-08/anchors-p4/clocks.sdc
  <Tool Version>: V1.9.12.04
  <Part Number>: GW2AR-LV18QN88C8/I7
  <Device>: GW2AR-18
  <Device Version>: C
  <Created Time>:Sun Nov  8 17:23:32 2026

2. PnR Details

  Running placement:
    Placement Phase 0: CPU time = 0h 0m 0.837s, Elapsed time = 0h 0m 0.846s
    Placement Phase 1: CPU time = 0h 0m 53s, Elapsed time = 0h 0m 54s
    Placement Phase 2: CPU time = 0h 0m 8s, Elapsed time = 0h 0m 8s
    Placement Phase 3: CPU time = 0h 0m 14s, Elapsed time = 0h 0m 15s
    Total Placement: CPU time = 0h 1m 16s, Elapsed time = 0h 1m 17s
 Running routing:
    Routing Phase 0: CPU time = 0h 0m 0.002s, Elapsed time = 0h 0m 0.002s
    Routing Phase 1: CPU time = 0h 0m 0.202s, Elapsed time = 0h 0m 0.204s
    Routing Phase 2: CPU time = 0h 0m 42s, Elapsed time = 0h 0m 42s
    Routing Phase 3: CPU time = 0h 0m 0s, Elapsed time = 0h 0m 0s
    Total Routing: CPU time = 0h 0m 42s, Elapsed time = 0h 0m 42s
 Generate output files:
    CPU time = 0h 0m 0.845s, Elapsed time = 0h 0m 0.856s

 Total Time and Memory Usage: CPU time = 0h 1m 59s, Elapsed time = 0h 2m 0s, Peak memory usage = 1207MB

3. Resource Usage Summary

  --------------------------------------------------------------------------------
  Resources                   | Usage                               | Utilization
  --------------------------------------------------------------------------------
  Logic                       | 15170/20736                         |  74%
    --LUT,ALU,ROM16           | 14978(13977 LUT, 1001 ALU, 0 ROM16) | -
    --SSRAM(RAM16)            | 32                                  | -
  Register                    | 5436/15915                          |  35%
    --Logic Register as Latch | 0/15552                             |  0%
    --Logic Register as FF    | 5383/15552                          |  35%
    --I/O Register as Latch   | 0/363                               |  0%
    --I/O Register as FF      | 53/363                              |  15%
  CLS                         | 8823/10368                          |  86%
  I/O Port                    | 10/66                               |  16%
  I/O Buf                     | 10                                  | -
    --Input Buf               | 4                                   | -
    --Output Buf              | 6                                   | -
    --Inout Buf               | 0                                   | -
  BSRAM                       | 40/46                               | 87%
    --SDPB                    | 37
    --SDPX9B                  | 2
    --pROM                    | 1
  DSP                         | 2.5/24                              | 11%
    --MULT18X18               | 1
    --MULTADDALU18X18         | 2
  ================================================================================

4. I/O Bank Usage Summary

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

5. Clock Resource Usage Summary

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

6. Global Clock Signals

  -------------------------------------------
  Signal         | Global Clock   | Location
  -------------------------------------------
  clk_27m_d      | PRIMARY        |  BR BL
  clk            | PRIMARY        |  TR TL BR BL
  clk_memory     | PRIMARY        |  TR TL BR BL
  O_sdram_clk_d  | PRIMARY        |  TR
  core/ds6_454_6 | PRIMARY        |  TR TL BR BL
  advance        | LW             |  -
  reset_sync[1]  | LW             |  -
  memory_reset_sync[1]| LW             |  -
  core/pipeState_8673_6| LW             |  -
  core/pipeState_8349_9| LW             |  -
  core/pipeState_7674_9| LW             |  -
  core/pipeState_7541_9| LW             |  -
  core/pipeState_7270_9| LW             |  -
  ===========================================

7. Pinout by Port Name

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

8. All Package Pins

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
