hyperswine/simple-risc/docs/evidence/2026-11-08-btb-feedback/feedback-p0/sdram_test.rpt.txt

//Copyright (C)2014-2026 Gowin Semiconductor Corporation.
//All rights reserved.

1. PnR Messages

  <Report Title>: PnR Report
  <Design File>: /Users/jasonqin/Documents/GitHub/simple-risc/output/btb-feedback-2026-11-08/feedback-source/impl/gwsynthesis/sdram_test.vg
  <Physical Constraints File>: /Users/jasonqin/Documents/GitHub/simple-risc/output/btb-feedback-2026-11-08/feedback-p0/pins.cst
  <Timing Constraints File>: /Users/jasonqin/Documents/GitHub/simple-risc/output/btb-feedback-2026-11-08/feedback-p0/clocks.sdc
  <Tool Version>: V1.9.12.04
  <Part Number>: GW2AR-LV18QN88C8/I7
  <Device>: GW2AR-18
  <Device Version>: C
  <Created Time>:Sun Nov  8 18:25:37 2026

2. PnR Details

  Running placement:
    Placement Phase 0: CPU time = 0h 0m 0.883s, Elapsed time = 0h 0m 0.907s
    Placement Phase 1: CPU time = 0h 0m 0.403s, Elapsed time = 0h 0m 0.406s
    Placement Phase 2: CPU time = 0h 0m 5s, Elapsed time = 0h 0m 5s
    Placement Phase 3: CPU time = 0h 0m 4s, Elapsed time = 0h 0m 4s
    Total Placement: CPU time = 0h 0m 10s, Elapsed time = 0h 0m 10s
 Running routing:
    Routing Phase 0: CPU time = 0h 0m 0.002s, Elapsed time = 0h 0m 0.003s
    Routing Phase 1: CPU time = 0h 0m 0.212s, Elapsed time = 0h 0m 0.218s
    Routing Phase 2: CPU time = 0h 3m 28s, Elapsed time = 0h 3m 29s
    Routing Phase 3: CPU time = 0h 0m 0s, Elapsed time = 0h 0m 0s
    Total Routing: CPU time = 0h 3m 28s, Elapsed time = 0h 3m 29s
 Generate output files:
    CPU time = 0h 0m 0.876s, Elapsed time = 0h 0m 0.891s

 Total Time and Memory Usage: CPU time = 0h 3m 39s, Elapsed time = 0h 3m 41s, Peak memory usage = 509MB

3. Resource Usage Summary

  --------------------------------------------------------------------------------
  Resources                   | Usage                               | Utilization
  --------------------------------------------------------------------------------
  Logic                       | 15170/20736                         |  74%
    --LUT,ALU,ROM16           | 14978(13977 LUT, 1001 ALU, 0 ROM16) | -
    --SSRAM(RAM16)            | 32                                  | -
  Register                    | 5436/15915                          |  35%
    --Logic Register as Latch | 0/15552                             |  0%
    --Logic Register as FF    | 5383/15552                          |  35%
    --I/O Register as Latch   | 0/363                               |  0%
    --I/O Register as FF      | 53/363                              |  15%
  CLS                         | 8833/10368                          |  86%
  I/O Port                    | 10/66                               |  16%
  I/O Buf                     | 10                                  | -
    --Input Buf               | 4                                   | -
    --Output Buf              | 6                                   | -
    --Inout Buf               | 0                                   | -
  BSRAM                       | 40/46                               | 87%
    --SDPB                    | 37
    --SDPX9B                  | 2
    --pROM                    | 1
  DSP                         | 2.5/24                              | 11%
    --MULT18X18               | 1
    --MULTADDALU18X18         | 2
  ================================================================================

4. I/O Bank Usage Summary

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

5. Clock Resource Usage Summary

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

6. Global Clock Signals

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

7. Pinout by Port Name

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

8. All Package Pins

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
