hyperswine/simple-risc/docs/evidence/2026-11-08-btb-floorplan/baseline-t87-p0/sdram_test.rpt.txt

//Copyright (C)2014-2026 Gowin Semiconductor Corporation.
//All rights reserved.

1. PnR Messages

  <Report Title>: PnR Report
  <Design File>: /Users/jasonqin/Documents/GitHub/simple-risc/output/btb-floorplan-2026-11-08/baseline-t87-source/impl/gwsynthesis/sdram_test.vg
  <Physical Constraints File>: /Users/jasonqin/Documents/GitHub/simple-risc/output/btb-floorplan-2026-11-08/baseline-t87-p0/pins.cst
  <Timing Constraints File>: /Users/jasonqin/Documents/GitHub/simple-risc/output/btb-floorplan-2026-11-08/baseline-t87-p0/clocks.sdc
  <Tool Version>: V1.9.12.04
  <Part Number>: GW2AR-LV18QN88C8/I7
  <Device>: GW2AR-18
  <Device Version>: C
  <Created Time>:Sun Nov  8 13:32:41 2026

2. PnR Details

  Running placement:
    Placement Phase 0: CPU time = 0h 0m 0.932s, Elapsed time = 0h 0m 0.96s
    Placement Phase 1: CPU time = 0h 0m 0.399s, Elapsed time = 0h 0m 0.41s
    Placement Phase 2: CPU time = 0h 0m 5s, Elapsed time = 0h 0m 6s
    Placement Phase 3: CPU time = 0h 0m 6s, Elapsed time = 0h 0m 6s
    Total Placement: CPU time = 0h 0m 12s, Elapsed time = 0h 0m 13s
 Running routing:
    Routing Phase 0: CPU time = 0h 0m 0.002s, Elapsed time = 0h 0m 0.002s
    Routing Phase 1: CPU time = 0h 0m 0.21s, Elapsed time = 0h 0m 0.212s
    Routing Phase 2: CPU time = 0h 5m 56s, Elapsed time = 0h 6m 8s
    Routing Phase 3: CPU time = 0h 0m 0s, Elapsed time = 0h 0m 0s
    Total Routing: CPU time = 0h 5m 57s, Elapsed time = 0h 6m 8s
 Generate output files:
    CPU time = 0h 0m 0.905s, Elapsed time = 0h 0m 0.95s

 Total Time and Memory Usage: CPU time = 0h 6m 10s, Elapsed time = 0h 6m 22s, Peak memory usage = 545MB

3. Resource Usage Summary

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

4. I/O Bank Usage Summary

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

5. Clock Resource Usage Summary

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

6. Global Clock Signals

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

7. Pinout by Port Name

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

8. All Package Pins

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
