hyperswine/simple-risc/docs/evidence/2026-10-28-control-area/baseline-fresh/sdram_test.rpt.txt

//Copyright (C)2014-2026 Gowin Semiconductor Corporation.
//All rights reserved.

1. PnR Messages

  <Report Title>: PnR Report
  <Design File>: /Users/jasonqin/Documents/GitHub/simple-risc/output/tangnano20k/control-area-20261028/baseline-fresh/impl/gwsynthesis/sdram_test.vg
  <Physical Constraints File>: /Users/jasonqin/Documents/GitHub/simple-risc/output/tangnano20k/control-area-20261028/baseline-fresh/pins.cst
  <Timing Constraints File>: /Users/jasonqin/Documents/GitHub/simple-risc/output/tangnano20k/control-area-20261028/baseline-fresh/clocks.sdc
  <Tool Version>: V1.9.12.04
  <Part Number>: GW2AR-LV18QN88C8/I7
  <Device>: GW2AR-18
  <Device Version>: C
  <Created Time>:Wed Oct 28 16:58:15 2026

2. PnR Details

  Running placement:
    Placement Phase 0: CPU time = 0h 0m 3s, Elapsed time = 0h 0m 3s
    Placement Phase 1: CPU time = 0h 0m 0.929s, Elapsed time = 0h 0m 0.945s
    Placement Phase 2: CPU time = 0h 0m 23s, Elapsed time = 0h 0m 24s
    Placement Phase 3: CPU time = 0h 1m 5s, Elapsed time = 0h 1m 6s
    Total Placement: CPU time = 0h 1m 33s, Elapsed time = 0h 1m 34s
 Running routing:
    Routing Phase 0: CPU time = 0h 0m 0.003s, Elapsed time = 0h 0m 0.003s
    Routing Phase 1: CPU time = 0h 0m 0.193s, Elapsed time = 0h 0m 0.196s
    Routing Phase 2: CPU time = 0h 0m 10s, Elapsed time = 0h 0m 10s
    Routing Phase 3: CPU time = 0h 0m 0s, Elapsed time = 0h 0m 0s
    Total Routing: CPU time = 0h 0m 10s, Elapsed time = 0h 0m 10s
 Generate output files:
    CPU time = 0h 0m 0.855s, Elapsed time = 0h 0m 0.863s

 Total Time and Memory Usage: CPU time = 0h 1m 44s, Elapsed time = 0h 1m 45s, Peak memory usage = 588MB

3. Resource Usage Summary

  --------------------------------------------------------------------------------
  Resources                   | Usage                               | Utilization
  --------------------------------------------------------------------------------
  Logic                       | 19592/20736                         |  95%
    --LUT,ALU,ROM16           | 19490(18506 LUT, 984 ALU, 0 ROM16)  | -
    --SSRAM(RAM16)            | 17                                  | -
  Register                    | 7360/15915                          |  47%
    --Logic Register as Latch | 0/15552                             |  0%
    --Logic Register as FF    | 7307/15552                          |  47%
    --I/O Register as Latch   | 0/363                               |  0%
    --I/O Register as FF      | 53/363                              |  15%
  CLS                         | 10260/10368                         |  99%
  I/O Port                    | 10/66                               |  16%
  I/O Buf                     | 10                                  | -
    --Input Buf               | 4                                   | -
    --Output Buf              | 6                                   | -
    --Inout Buf               | 0                                   | -
  BSRAM                       | 37/46                               | 81%
    --SDPB                    | 34
    --SDPX9B                  | 2
    --pROM                    | 1
  DSP                         | 3/24                                | 13%
    --MULT18X18               | 4
    --ALU54D                  | 1
  ================================================================================

4. I/O Bank Usage Summary

  --------------------------------------
  I/O Bank  | Usage       | Utilization 
  --------------------------------------
  bank 0   | 6/8         | 75%         
  bank 1   | 2/9         | 23%         
  bank 2   | 0/4         | 0%          
  bank 3   | 1/17        | 6%          
  bank 4   | 0/8         | 0%          
  bank 5   | 0/10        | 0%          
  bank 6   | 0/9         | 0%          
  bank 7   | 1/1         | 100%        
  ======================================

5. Clock Resource Usage Summary

  ------------------------------------------
  Clock Resource| Usage         | Utilization 
  ------------------------------------------
  PRIMARY       | 4/8           | 50%
  LW            | 8/8           | 100%
  GCLK_PIN      | 1/5           | 20%
  rPLL          | 1/2           | 50%
  ==========================================

6. Global Clock Signals

  -------------------------------------------
  Signal         | Global Clock   | Location
  -------------------------------------------
  clk_27m_d      | PRIMARY        |  BL
  clk            | PRIMARY        |  TR TL BR BL
  O_sdram_clk_d  | PRIMARY        |  TR
  core/machine_0_1609_8| PRIMARY        |  TR BR
  advance        | LW             |  -
  memory_reset_sync[1]| LW             |  -
  core/machine_0_5232_9| LW             |  -
  core/machine_0_5099_9| LW             |  -
  core/machine_0_4966_9| LW             |  -
  core/machine_0_4833_9| LW             |  -
  core/machine_0_4557_9| LW             |  -
  core/machine_0_4424_9| LW             |  -
  ===========================================

7. Pinout by Port Name

-------------------------------------------------------------------------------------------------------------------------------------------------------------------------------------------------------------------------
Port Name         | Diff Pair | Loc./Bank     | Constraint | Dir.  | Site     | CFG             | IO Type    | Drive | Pull Mode | PCI Clamp | Hysteresis | Open Drain | Vref       | Single Resistor | Diff Resistor | BankVccio 
-------------------------------------------------------------------------------------------------------------------------------------------------------------------------------------------------------------------------
clk_27m           | -         | 4/7           | Y          | in    | IOL7[A]  | LPLL1_T_in      | LVCMOS33   | NA    | UP        | ON        | NONE       | NA         | NA         | OFF             | NA            | 3.3       
btn_s1            | -         | 88/3          | Y          | in    | IOR30[A] | MODE0           | LVCMOS33   | NA    | DOWN      | ON        | NONE       | NA         | NA         | OFF             | NA            | 3.3       
uart_rx           | -         | 70/1          | Y          | in    | IOT44[B] | -               | LVCMOS33   | NA    | UP        | ON        | NONE       | NA         | NA         | NA              | NA            | 3.3       
sd_dat0           | -         | 84/0          | Y          | in    | IOT6[A]  | -               | LVCMOS33   | NA    | UP        | ON        | NONE       | NA         | NA         | NA              | NA            | 3.3       
uart_tx           | -         | 69/1          | Y          | out   | IOT50[A] | -               | LVCMOS33   | 8     | UP        | NA        | NA         | OFF        | NA         | NA              | NA            | 3.3       
sd_clk            | -         | 83/0          | Y          | out   | IOT6[B]  | -               | LVCMOS33   | 8     | NONE      | NA        | NA         | OFF        | NA         | NA              | NA            | 3.3       
sd_cmd            | -         | 82/0          | Y          | out   | IOT17[A] | -               | LVCMOS33   | 8     | NONE      | NA        | NA         | OFF        | NA         | NA              | NA            | 3.3       
sd_dat1           | -         | 85/0          | Y          | out   | IOT4[B]  | -               | LVCMOS33   | 8     | NONE      | NA        | NA         | OFF        | NA         | NA              | NA            | 3.3       
sd_dat2           | -         | 80/0          | Y          | out   | IOT27[A] | GCLKT_0         | LVCMOS33   | 8     | NONE      | NA        | NA         | OFF        | NA         | NA              | NA            | 3.3       
sd_dat3           | -         | 81/0          | Y          | out   | IOT17[B] | -               | LVCMOS33   | 8     | NONE      | NA        | NA         | OFF        | NA         | NA              | NA            | 3.3       
O_sdram_clk       | -         | p73/2         | -          | out   | IOR11[B] | -               | LVTTL33    | -     | UP        | -         | -          | -          | -          | -               | -             | -         
O_sdram_cke       | -         | p18/7         | -          | out   | IOL13[A] | -               | LVTTL33    | -     | UP        | -         | -          | -          | -          | -               | -             | -         
O_sdram_cs_n      | -         | p22/7         | -          | out   | IOL14[B] | -               | LVTTL33    | -     | UP        | -         | -          | -          | -          | -               | -             | -         
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
=========================================================================================================================================================================================================================

8. All Package Pins

----------------------------------------------------------------------------------------------------------------------------------------------------------------------------------------------
Loc./Bank| Signal            | Dir.  | Site     | CFG             | IO Type  | Drive | Pull Mode | PCI Clamp | Hysteresis | Open Drain | Vref       | Single Resistor | Diff Resistor | Bank Vccio
----------------------------------------------------------------------------------------------------------------------------------------------------------------------------------------------
86/0     | -                 | in    | IOT4[A]  | -               | LVCMOS33 | NA    | UP        | ON        | NONE       | NA         | NA         | NA              | NA            | 3.3  
85/0     | sd_dat1           | out   | IOT4[B]  | -               | LVCMOS33 | 8     | NONE      | NA        | NA         | OFF        | NA         | NA              | NA            | 3.3  
84/0     | sd_dat0           | in    | IOT6[A]  | -               | LVCMOS33 | NA    | UP        | ON        | NONE       | NA         | NA         | NA              | NA            | 3.3  
83/0     | sd_clk            | out   | IOT6[B]  | -               | LVCMOS33 | 8     | NONE      | NA        | NA         | OFF        | NA         | NA              | NA            | 3.3  
82/0     | sd_cmd            | out   | IOT17[A] | -               | LVCMOS33 | 8     | NONE      | NA        | NA         | OFF        | NA         | NA              | NA            | 3.3  
81/0     | sd_dat3           | out   | IOT17[B] | -               | LVCMOS33 | 8     | NONE      | NA        | NA         | OFF        | NA         | NA              | NA            | 3.3  
80/0     | sd_dat2           | out   | IOT27[A] | GCLKT_0         | LVCMOS33 | 8     | NONE      | NA        | NA         | OFF        | NA         | NA              | NA            | 3.3  
79/0     | -                 | in    | IOT27[B] | GCLKC_0         | LVCMOS33 | NA    | UP        | ON        | NONE       | NA         | NA         | NA              | NA            | 3.3  
77/1     | -                 | in    | IOT30[A] | GCLKT_1         | LVCMOS33 | NA    | UP        | ON        | NONE       | NA         | NA         | NA              | NA            | 3.3  
76/1     | -                 | in    | IOT30[B] | GCLKC_1         | LVCMOS33 | NA    | UP        | ON        | NONE       | NA         | NA         | NA              | NA            | 3.3  
75/1     | -                 | in    | IOT34[A] | -               | LVCMOS33 | NA    | UP        | ON        | NONE       | NA         | NA         | NA              | NA            | 3.3  
74/1     | -                 | in    | IOT34[B] | -               | LVCMOS33 | NA    | UP        | ON        | NONE       | NA         | NA         | NA              | NA            | 3.3  
73/1     | -                 | in    | IOT40[A] | -               | LVCMOS33 | NA    | UP        | ON        | NONE       | NA         | NA         | NA              | NA            | 3.3  
72/1     | -                 | in    | IOT40[B] | -               | LVCMOS33 | NA    | UP        | ON        | NONE       | NA         | NA         | NA              | NA            | 3.3  
71/1     | -                 | in    | IOT44[A] | -               | LVCMOS33 | NA    | UP        | ON        | NONE       | NA         | NA         | NA              | NA            | 3.3  
70/1     | uart_rx           | in    | IOT44[B] | -               | LVCMOS33 | NA    | UP        | ON        | NONE       | NA         | NA         | NA              | NA            | 3.3  
69/1     | uart_tx           | out   | IOT50[A] | -               | LVCMOS33 | 8     | UP        | NA        | NA         | OFF        | NA         | NA              | NA            | 3.3  
----------------------------------------------------------------------------------------------------------------------------------------------------------------------------------------------
25/5     | -                 | in    | IOB6[A]  | -               | LVCMOS18 | NA    | UP        | ON        | NONE       | NA         | NA         | NA              | NA            | 1.8  
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
8/2      | -                 | out   | IOR25[A] | TDO             | LVCMOS33 | 8     | UP        | NA        | NA         | OFF        | NA         | NA              | NA            | 3.3  
5/2      | -                 | in    | IOR25[B] | TMS             | LVCMOS33 | NA    | UP        | ON        | NONE       | NA         | NA         | NA              | NA            | 3.3  
6/2      | -                 | in    | IOR26[A] | TCK             | LVCMOS33 | NA    | UP        | ON        | NONE       | NA         | NA         | NA              | NA            | 3.3  
7/2      | -                 | in    | IOR26[B] | TDI             | LVCMOS33 | NA    | UP        | ON        | NONE       | NA         | NA         | NA              | NA            | 3.3  
63/3     | -                 | in    | IOR29[A] | GCLKT_3         | LVCMOS33 | NA    | UP        | ON        | NONE       | NA         | NA         | NA              | NA            | 3.3  
88/3     | btn_s1            | in    | IOR30[A] | MODE0           | LVCMOS33 | NA    | DOWN      | ON        | NONE       | NA         | NA         | OFF             | NA            | 3.3  
87/3     | -                 | in    | IOR30[B] | MODE1           | LVCMOS33 | NA    | UP        | ON        | NONE       | NA         | NA         | NA              | NA            | 3.3  
9/3      | -                 | in    | IOR31[B] | RECONFIG_N      | LVCMOS33 | NA    | UP        | ON        | NONE       | NA         | NA         | NA              | NA            | 3.3  
62/3     | -                 | in    | IOR33[A] | MI/D7           | LVCMOS33 | NA    | UP        | ON        | NONE       | NA         | NA         | NA              | NA            | 3.3  
61/3     | -                 | in    | IOR33[B] | MO/D6           | LVCMOS33 | NA    | UP        | ON        | NONE       | NA         | NA         | NA              | NA            | 3.3  
60/3     | -                 | in    | IOR34[A] | MCS_N/D5        | LVCMOS33 | NA    | UP        | ON        | NONE       | NA         | NA         | NA              | NA            | 3.3  
59/3     | -                 | in    | IOR34[B] | MCLK/D4         | LVCMOS33 | NA    | UP        | ON        | NONE       | NA         | NA         | NA              | NA            | 3.3  
57/3     | -                 | in    | IOR35[A] | FASTRD_N/D3     | LVCMOS33 | NA    | UP        | ON        | NONE       | NA         | NA         | NA              | NA            | 3.3  
56/3     | -                 | in    | IOR36[A] | SO/D1           | LVCMOS33 | NA    | UP        | ON        | NONE       | NA         | NA         | NA              | NA            | 3.3  
55/3     | -                 | in    | IOR36[B] | SSPI_CS_N/D0    | LVCMOS33 | NA    | UP        | ON        | NONE       | NA         | NA         | NA              | NA            | 3.3  
54/3     | -                 | in    | IOR38[A] | DIN/CLKHOLD_N   | LVCMOS33 | NA    | UP        | ON        | NONE       | NA         | NA         | NA              | NA            | 3.3  
53/3     | -                 | in    | IOR38[B] | DOUT/WE_N       | LVCMOS33 | NA    | UP        | ON        | NONE       | NA         | NA         | NA              | NA            | 3.3  
52/3     | -                 | in    | IOR39[A] | SCLK            | LVCMOS33 | NA    | UP        | ON        | NONE       | NA         | NA         | NA              | NA            | 3.3  
p49/3    | IO_sdram_dq[30]   | io    | IOR44[A] | -               | LVTTL33  | -     | UP        | -         | -          | -          | -          | -               | -             | -    
p48/3    | IO_sdram_dq[31]   | io    | IOR44[B] | -               | LVTTL33  | -     | UP        | -         | -          | -          | -          | -               | -             | -    
51/3     | -                 | in    | IOR45[A] | RPLL2_T_in      | LVCMOS33 | NA    | UP        | ON        | NONE       | NA         | NA         | NA              | NA            | 3.3  
49/3     | -                 | in    | IOR49[A] | -               | LVCMOS33 | NA    | UP        | ON        | NONE       | NA         | NA         | NA              | NA            | 3.3  
48/3     | -                 | in    | IOR49[B] | -               | LVCMOS33 | NA    | UP        | ON        | NONE       | NA         | NA         | NA              | NA            | 3.3  
----------------------------------------------------------------------------------------------------------------------------------------------------------------------------------------------
==============================================================================================================================================================================================
