hyperswine/simple-risc/docs/evidence/2026-10-28-control-area/mru-ram/sdram_test.rpt.txt

//Copyright (C)2014-2026 Gowin Semiconductor Corporation.
//All rights reserved.

1. PnR Messages

  <Report Title>: PnR Report
  <Design File>: /Users/jasonqin/Documents/GitHub/simple-risc/output/tangnano20k/control-area-20261028/mru-ram/impl/gwsynthesis/sdram_test.vg
  <Physical Constraints File>: /Users/jasonqin/Documents/GitHub/simple-risc/output/tangnano20k/control-area-20261028/mru-ram/pins.cst
  <Timing Constraints File>: /Users/jasonqin/Documents/GitHub/simple-risc/output/tangnano20k/control-area-20261028/mru-ram/clocks.sdc
  <Tool Version>: V1.9.12.04
  <Part Number>: GW2AR-LV18QN88C8/I7
  <Device>: GW2AR-18
  <Device Version>: C
  <Created Time>:Wed Oct 28 16:54:18 2026

2. PnR Details

  Running placement:
    Placement Phase 0: CPU time = 0h 0m 1s, Elapsed time = 0h 0m 1s
    Placement Phase 1: CPU time = 0h 0m 0.781s, Elapsed time = 0h 0m 0.807s
    Placement Phase 2: CPU time = 0h 0m 22s, Elapsed time = 0h 0m 22s
    Placement Phase 3: CPU time = 0h 1m 23s, Elapsed time = 0h 1m 25s
    Total Placement: CPU time = 0h 1m 46s, Elapsed time = 0h 1m 49s
 Running routing:
    Routing Phase 0: CPU time = 0h 0m 0.011s, Elapsed time = 0h 0m 0.012s
    Routing Phase 1: CPU time = 0h 0m 0.664s, Elapsed time = 0h 0m 0.675s
    Routing Phase 2: CPU time = 0h 0m 23s, Elapsed time = 0h 0m 23s
    Routing Phase 3: CPU time = 0h 0m 0s, Elapsed time = 0h 0m 0s
    Total Routing: CPU time = 0h 0m 23s, Elapsed time = 0h 0m 24s
 Generate output files:
    CPU time = 0h 0m 4s, Elapsed time = 0h 0m 4s

 Total Time and Memory Usage: CPU time = 0h 2m 13s, Elapsed time = 0h 2m 17s, Peak memory usage = 506MB

3. Resource Usage Summary

  --------------------------------------------------------------------------------
  Resources                   | Usage                               | Utilization
  --------------------------------------------------------------------------------
  Logic                       | 15911/20736                         |  77%
    --LUT,ALU,ROM16           | 15041(14048 LUT, 993 ALU, 0 ROM16)  | -
    --SSRAM(RAM16)            | 145                                 | -
  Register                    | 5308/15915                          |  34%
    --Logic Register as Latch | 0/15552                             |  0%
    --Logic Register as FF    | 5255/15552                          |  34%
    --I/O Register as Latch   | 0/363                               |  0%
    --I/O Register as FF      | 53/363                              |  15%
  CLS                         | 8856/10368                          |  86%
  I/O Port                    | 10/66                               |  16%
  I/O Buf                     | 10                                  | -
    --Input Buf               | 4                                   | -
    --Output Buf              | 6                                   | -
    --Inout Buf               | 0                                   | -
  BSRAM                       | 37/46                               | 81%
    --SDPB                    | 34
    --SDPX9B                  | 2
    --pROM                    | 1
  DSP                         | 3/24                                | 13%
    --MULT18X18               | 4
    --ALU54D                  | 1
  ================================================================================

4. I/O Bank Usage Summary

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

5. Clock Resource Usage Summary

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

6. Global Clock Signals

  -------------------------------------------
  Signal         | Global Clock   | Location
  -------------------------------------------
  clk_27m_d      | PRIMARY        |  BL
  clk            | PRIMARY        |  TR TL BR BL
  O_sdram_clk_d  | PRIMARY        |  TR
  core/machine_0_4153_9| PRIMARY        |  TR
  advance        | LW             |  -
  memory_reset_sync[1]| LW             |  -
  core/machine_0_5232_9| LW             |  -
  core/machine_0_5099_9| LW             |  -
  core/machine_0_4966_9| LW             |  -
  core/machine_0_4833_9| LW             |  -
  core/machine_0_4557_9| LW             |  -
  core/machine_0_4424_9| LW             |  -
  ===========================================

7. Pinout by Port Name

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

8. All Package Pins

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
