hyperswine/simple-risc/docs/evidence/2026-11-07-refactor/physical/candidate-p0/sdram_test.rpt.txt

//Copyright (C)2014-2026 Gowin Semiconductor Corporation.
//All rights reserved.

1. PnR Messages

  <Report Title>: PnR Report
  <Design File>: /Users/jasonqin/Documents/GitHub/simple-risc/output/refactor-2026-11-07/candidate-physical/impl/gwsynthesis/sdram_test.vg
  <Physical Constraints File>: /Users/jasonqin/Documents/GitHub/simple-risc/output/refactor-2026-11-07/candidate-p0/pins.cst
  <Timing Constraints File>: /Users/jasonqin/Documents/GitHub/simple-risc/output/refactor-2026-11-07/candidate-p0/clocks.sdc
  <Tool Version>: V1.9.12.04
  <Part Number>: GW2AR-LV18QN88C8/I7
  <Device>: GW2AR-18
  <Device Version>: C
  <Created Time>:Sun Nov  8 00:01:58 2026

2. PnR Details

  Running placement:
    Placement Phase 0: CPU time = 0h 0m 0.819s, Elapsed time = 0h 0m 0.833s
    Placement Phase 1: CPU time = 0h 0m 0.321s, Elapsed time = 0h 0m 0.327s
    Placement Phase 2: CPU time = 0h 0m 4s, Elapsed time = 0h 0m 4s
    Placement Phase 3: CPU time = 0h 0m 5s, Elapsed time = 0h 0m 5s
    Total Placement: CPU time = 0h 0m 10s, Elapsed time = 0h 0m 11s
 Running routing:
    Routing Phase 0: CPU time = 0h 0m 0.002s, Elapsed time = 0h 0m 0.002s
    Routing Phase 1: CPU time = 0h 0m 0.191s, Elapsed time = 0h 0m 0.193s
    Routing Phase 2: CPU time = 0h 11m 39s, Elapsed time = 0h 11m 46s
    Routing Phase 3: CPU time = 0h 0m 0s, Elapsed time = 0h 0m 0s
    Total Routing: CPU time = 0h 11m 40s, Elapsed time = 0h 11m 46s
 Generate output files:
    CPU time = 0h 0m 0.89s, Elapsed time = 0h 0m 0.905s

 Total Time and Memory Usage: CPU time = 0h 11m 51s, Elapsed time = 0h 11m 58s, Peak memory usage = 586MB

3. Resource Usage Summary

  --------------------------------------------------------------------------------
  Resources                   | Usage                               | Utilization
  --------------------------------------------------------------------------------
  Logic                       | 14820/20736                         |  72%
    --LUT,ALU,ROM16           | 14628(13661 LUT, 967 ALU, 0 ROM16)  | -
    --SSRAM(RAM16)            | 32                                  | -
  Register                    | 5435/15915                          |  35%
    --Logic Register as Latch | 0/15552                             |  0%
    --Logic Register as FF    | 5382/15552                          |  35%
    --I/O Register as Latch   | 0/363                               |  0%
    --I/O Register as FF      | 53/363                              |  15%
  CLS                         | 8790/10368                          |  85%
  I/O Port                    | 10/66                               |  16%
  I/O Buf                     | 10                                  | -
    --Input Buf               | 4                                   | -
    --Output Buf              | 6                                   | -
    --Inout Buf               | 0                                   | -
  BSRAM                       | 40/46                               | 87%
    --SDPB                    | 37
    --SDPX9B                  | 2
    --pROM                    | 1
  DSP                         | 2.5/24                              | 11%
    --MULT18X18               | 1
    --MULTADDALU18X18         | 2
  ================================================================================

4. I/O Bank Usage Summary

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

5. Clock Resource Usage Summary

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

6. Global Clock Signals

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

7. Pinout by Port Name

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

8. All Package Pins

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
