hyperswine/simple-risc/docs/evidence/2026-11-08-four-trials/dsp/dsp-floorplan-p0/sdram_test.rpt.txt

//Copyright (C)2014-2026 Gowin Semiconductor Corporation.
//All rights reserved.

1. PnR Messages

  <Report Title>: PnR Report
  <Design File>: /Users/jasonqin/Documents/GitHub/simple-risc/output/refactor-four-2026-11-08/dsp-floorplan-p0-source/impl/gwsynthesis/sdram_test.vg
  <Physical Constraints File>: /Users/jasonqin/Documents/GitHub/simple-risc/output/refactor-four-2026-11-08/dsp-floorplan-p0/pins.cst
  <Timing Constraints File>: /Users/jasonqin/Documents/GitHub/simple-risc/output/refactor-four-2026-11-08/dsp-floorplan-p0/clocks.sdc
  <Tool Version>: V1.9.12.04
  <Part Number>: GW2AR-LV18QN88C8/I7
  <Device>: GW2AR-18
  <Device Version>: C
  <Created Time>:Sun Nov  8 04:35:12 2026

2. PnR Details

  Running placement:
    Placement Phase 0: CPU time = 0h 0m 0.831s, Elapsed time = 0h 0m 0.831s
    Placement Phase 1: CPU time = 0h 0m 0.438s, Elapsed time = 0h 0m 0.439s
    Placement Phase 2: CPU time = 0h 0m 5s, Elapsed time = 0h 0m 5s
    Placement Phase 3: CPU time = 0h 0m 4s, Elapsed time = 0h 0m 4s
    Total Placement: CPU time = 0h 0m 10s, Elapsed time = 0h 0m 10s
 Running routing:
    Routing Phase 0: CPU time = 0h 0m 0.002s, Elapsed time = 0h 0m 0.002s
    Routing Phase 1: CPU time = 0h 0m 0.201s, Elapsed time = 0h 0m 0.201s
    Routing Phase 2: CPU time = 0h 9m 29s, Elapsed time = 0h 9m 29s
    Routing Phase 3: CPU time = 0h 0m 0s, Elapsed time = 0h 0m 0s
    Total Routing: CPU time = 0h 9m 29s, Elapsed time = 0h 9m 30s
 Generate output files:
    CPU time = 0h 0m 0.838s, Elapsed time = 0h 0m 0.846s

 Total Time and Memory Usage: CPU time = 0h 9m 40s, Elapsed time = 0h 9m 40s, Peak memory usage = 577MB

3. Resource Usage Summary

  --------------------------------------------------------------------------------
  Resources                   | Usage                               | Utilization
  --------------------------------------------------------------------------------
  Logic                       | 15082/20736                         |  73%
    --LUT,ALU,ROM16           | 14890(13889 LUT, 1001 ALU, 0 ROM16) | -
    --SSRAM(RAM16)            | 32                                  | -
  Register                    | 5403/15915                          |  34%
    --Logic Register as Latch | 0/15552                             |  0%
    --Logic Register as FF    | 5350/15552                          |  35%
    --I/O Register as Latch   | 0/363                               |  0%
    --I/O Register as FF      | 53/363                              |  15%
  CLS                         | 8754/10368                          |  85%
  I/O Port                    | 10/66                               |  16%
  I/O Buf                     | 10                                  | -
    --Input Buf               | 4                                   | -
    --Output Buf              | 6                                   | -
    --Inout Buf               | 0                                   | -
  BSRAM                       | 40/46                               | 87%
    --SDPB                    | 37
    --SDPX9B                  | 2
    --pROM                    | 1
  DSP                         | 3.5/24                              | 15%
    --MULT18X18               | 1
    --MULTADDALU18X18         | 2
    --ALU54D                  | 1
  ================================================================================

4. I/O Bank Usage Summary

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

5. Clock Resource Usage Summary

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

6. Global Clock Signals

  -------------------------------------------
  Signal         | Global Clock   | Location
  -------------------------------------------
  clk_27m_d      | PRIMARY        |  BR BL
  clk            | PRIMARY        |  TR TL BR BL
  clk_memory     | PRIMARY        |  TR TL BR BL
  O_sdram_clk_d  | PRIMARY        |  TR
  core/logic_core/pipeState_7674_9| PRIMARY        |  TR TL BR
  advance        | LW             |  -
  reset_sync[1]  | LW             |  -
  memory_reset_sync[1]| LW             |  -
  core/logic_core/pipeState_8673_6| LW             |  -
  core/logic_core/pipeState_8349_9| LW             |  -
  core/logic_core/pipeState_8216_9| LW             |  -
  core/logic_core/pipeState_8083_9| LW             |  -
  core/logic_core/pipeState_7950_9| LW             |  -
  ===========================================

7. Pinout by Port Name

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

8. All Package Pins

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
