hyperswine/simple-risc/docs/evidence/2026-10-28-controlled-benchmark/hardware/baseline/sdram_test.rpt.txt

//Copyright (C)2014-2026 Gowin Semiconductor Corporation.
//All rights reserved.

1. PnR Messages

  <Report Title>: PnR Report
  <Design File>: /Users/jasonqin/Documents/GitHub/simple-risc/output/tangnano20k/benchmark-matrix-20261028/hardware/baseline/impl/gwsynthesis/sdram_test.vg
  <Physical Constraints File>: /Users/jasonqin/Documents/GitHub/simple-risc/output/tangnano20k/benchmark-matrix-20261028/hardware/baseline/pins.cst
  <Timing Constraints File>: /Users/jasonqin/Documents/GitHub/simple-risc/output/tangnano20k/benchmark-matrix-20261028/hardware/baseline/clocks.sdc
  <Tool Version>: V1.9.12.04
  <Part Number>: GW2AR-LV18QN88C8/I7
  <Device>: GW2AR-18
  <Device Version>: C
  <Created Time>:Wed Oct 28 16:07:19 2026

2. PnR Details

  Running placement:
    Placement Phase 0: CPU time = 0h 0m 4s, Elapsed time = 0h 0m 4s
    Placement Phase 1: CPU time = 0h 0m 0.435s, Elapsed time = 0h 0m 0.444s
    Placement Phase 2: CPU time = 0h 0m 17s, Elapsed time = 0h 0m 17s
    Placement Phase 3: CPU time = 0h 0m 45s, Elapsed time = 0h 0m 46s
    Total Placement: CPU time = 0h 1m 6s, Elapsed time = 0h 1m 7s
 Running routing:
    Routing Phase 0: CPU time = 0h 0m 0.007s, Elapsed time = 0h 0m 0.007s
    Routing Phase 1: CPU time = 0h 0m 0.384s, Elapsed time = 0h 0m 0.406s
    Routing Phase 2: CPU time = 0h 0m 15s, Elapsed time = 0h 0m 17s
    Routing Phase 3: CPU time = 0h 0m 0s, Elapsed time = 0h 0m 0s
    Total Routing: CPU time = 0h 0m 15s, Elapsed time = 0h 0m 18s
 Generate output files:
    CPU time = 0h 0m 2s, Elapsed time = 0h 0m 2s

 Total Time and Memory Usage: CPU time = 0h 1m 23s, Elapsed time = 0h 1m 27s, Peak memory usage = 447MB

3. Resource Usage Summary

  --------------------------------------------------------------------------------
  Resources                   | Usage                               | Utilization
  --------------------------------------------------------------------------------
  Logic                       | 16210/20736                         |  79%
    --LUT,ALU,ROM16           | 16108(15212 LUT, 896 ALU, 0 ROM16)  | -
    --SSRAM(RAM16)            | 17                                  | -
  Register                    | 4968/15915                          |  32%
    --Logic Register as Latch | 0/15552                             |  0%
    --Logic Register as FF    | 4915/15552                          |  32%
    --I/O Register as Latch   | 0/363                               |  0%
    --I/O Register as FF      | 53/363                              |  15%
  CLS                         | 8854/10368                          |  86%
  I/O Port                    | 10/66                               |  16%
  I/O Buf                     | 10                                  | -
    --Input Buf               | 4                                   | -
    --Output Buf              | 6                                   | -
    --Inout Buf               | 0                                   | -
  BSRAM                       | 37/46                               | 81%
    --SDPB                    | 36
    --pROM                    | 1
  DSP                         | 3/24                                | 13%
    --MULT18X18               | 4
    --ALU54D                  | 1
  ================================================================================

4. I/O Bank Usage Summary

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

5. Clock Resource Usage Summary

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

6. Global Clock Signals

  -------------------------------------------
  Signal         | Global Clock   | Location
  -------------------------------------------
  clk_27m_d      | PRIMARY        |  BL
  clk            | PRIMARY        |  TR TL BR BL
  O_sdram_clk_d  | PRIMARY        |  TR
  core/machine_0_4424_9| PRIMARY        |  TR TL BR
  advance        | LW             |  -
  memory_reset_sync[1]| LW             |  -
  core/machine_0_5232_9| LW             |  -
  core/machine_0_5099_9| LW             |  -
  core/machine_0_4966_9| LW             |  -
  core/machine_0_4833_9| LW             |  -
  core/machine_0_4557_9| LW             |  -
  core/machine_0_5529_13| LW             |  -
  ===========================================

7. Pinout by Port Name

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

8. All Package Pins

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
