hyperswine/simple-risc/docs/evidence/2026-10-30-structural-queues/build/impl/pnr/sdram_test.rpt.txt

//Copyright (C)2014-2026 Gowin Semiconductor Corporation.
//All rights reserved.

1. PnR Messages

  <Report Title>: PnR Report
  <Design File>: /Users/jasonqin/Documents/GitHub/simple-risc/output/tangnano20k/structural-queues-20261030/fqueue/hardware-48/impl/gwsynthesis/sdram_test.vg
  <Physical Constraints File>: /Users/jasonqin/Documents/GitHub/simple-risc/output/tangnano20k/structural-queues-20261030/fqueue/hardware-48/pins.cst
  <Timing Constraints File>: /Users/jasonqin/Documents/GitHub/simple-risc/output/tangnano20k/structural-queues-20261030/fqueue/hardware-48/clocks.sdc
  <Tool Version>: V1.9.12.04
  <Part Number>: GW2AR-LV18QN88C8/I7
  <Device>: GW2AR-18
  <Device Version>: C
  <Created Time>:Fri Oct 30 03:50:06 2026

2. PnR Details

  Running placement:
    Placement Phase 0: CPU time = 0h 0m 3s, Elapsed time = 0h 0m 3s
    Placement Phase 1: CPU time = 0h 0m 0.784s, Elapsed time = 0h 0m 0.791s
    Placement Phase 2: CPU time = 0h 0m 18s, Elapsed time = 0h 0m 18s
    Placement Phase 3: CPU time = 0h 1m 2s, Elapsed time = 0h 1m 9s
    Total Placement: CPU time = 0h 1m 24s, Elapsed time = 0h 1m 31s
 Running routing:
    Routing Phase 0: CPU time = 0h 0m 0.01s, Elapsed time = 0h 0m 0.01s
    Routing Phase 1: CPU time = 0h 0m 0.734s, Elapsed time = 0h 0m 0.771s
    Routing Phase 2: CPU time = 0h 1m 8s, Elapsed time = 0h 1m 19s
    Routing Phase 3: CPU time = 0h 0m 0s, Elapsed time = 0h 0m 0s
    Total Routing: CPU time = 0h 1m 9s, Elapsed time = 0h 1m 19s
 Generate output files:
    CPU time = 0h 0m 3s, Elapsed time = 0h 0m 3s

 Total Time and Memory Usage: CPU time = 0h 2m 36s, Elapsed time = 0h 2m 54s, Peak memory usage = 418MB

3. Resource Usage Summary

  --------------------------------------------------------------------------------
  Resources                   | Usage                               | Utilization
  --------------------------------------------------------------------------------
  Logic                       | 14649/20736                         |  71%
    --LUT,ALU,ROM16           | 14547(13644 LUT, 903 ALU, 0 ROM16)  | -
    --SSRAM(RAM16)            | 17                                  | -
  Register                    | 5308/15915                          |  34%
    --Logic Register as Latch | 0/15552                             |  0%
    --Logic Register as FF    | 5255/15552                          |  34%
    --I/O Register as Latch   | 0/363                               |  0%
    --I/O Register as FF      | 53/363                              |  15%
  CLS                         | 8397/10368                          |  81%
  I/O Port                    | 10/66                               |  16%
  I/O Buf                     | 10                                  | -
    --Input Buf               | 4                                   | -
    --Output Buf              | 6                                   | -
    --Inout Buf               | 0                                   | -
  BSRAM                       | 38/46                               | 83%
    --SDPB                    | 35
    --SDPX9B                  | 2
    --pROM                    | 1
  DSP                         | 3.5/24                              | 15%
    --MULT18X18               | 1
    --MULTADDALU18X18         | 2
    --ALU54D                  | 1
  ================================================================================

4. I/O Bank Usage Summary

  --------------------------------------
  I/O Bank  | Usage       | Utilization 
  --------------------------------------
  bank 0   | 6/8         | 75%         
  bank 1   | 2/9         | 23%         
  bank 2   | 0/4         | 0%          
  bank 3   | 1/17        | 6%          
  bank 4   | 0/8         | 0%          
  bank 5   | 0/10        | 0%          
  bank 6   | 0/9         | 0%          
  bank 7   | 1/1         | 100%        
  ======================================

5. Clock Resource Usage Summary

  ------------------------------------------
  Clock Resource| Usage         | Utilization 
  ------------------------------------------
  PRIMARY       | 4/8           | 50%
  LW            | 8/8           | 100%
  GCLK_PIN      | 1/5           | 20%
  rPLL          | 1/2           | 50%
  ==========================================

6. Global Clock Signals

  -------------------------------------------
  Signal         | Global Clock   | Location
  -------------------------------------------
  clk_27m_d      | PRIMARY        |  BL
  clk            | PRIMARY        |  TR TL BR BL
  O_sdram_clk_d  | PRIMARY        |  TR
  core/pipeState_45_9| PRIMARY        |  TR BR
  advance        | LW             |  -
  memory_reset_sync[1]| LW             |  -
  core/pipeState_3431_6| LW             |  -
  core/result_214_2780_5| LW             |  -
  core/pipeState_3107_14| LW             |  -
  core/pipeState_2974_11| LW             |  -
  core/pipeState_2841_11| LW             |  -
  core/c$ds_app_arg_29[22]| LW             |  -
  ===========================================

7. Pinout by Port Name

-------------------------------------------------------------------------------------------------------------------------------------------------------------------------------------------------------------------------
Port Name         | Diff Pair | Loc./Bank     | Constraint | Dir.  | Site     | CFG             | IO Type    | Drive | Pull Mode | PCI Clamp | Hysteresis | Open Drain | Vref       | Single Resistor | Diff Resistor | BankVccio 
-------------------------------------------------------------------------------------------------------------------------------------------------------------------------------------------------------------------------
clk_27m           | -         | 4/7           | Y          | in    | IOL7[A]  | LPLL1_T_in      | LVCMOS33   | NA    | UP        | ON        | NONE       | NA         | NA         | OFF             | NA            | 3.3       
btn_s1            | -         | 88/3          | Y          | in    | IOR30[A] | MODE0           | LVCMOS33   | NA    | DOWN      | ON        | NONE       | NA         | NA         | OFF             | NA            | 3.3       
uart_rx           | -         | 70/1          | Y          | in    | IOT44[B] | -               | LVCMOS33   | NA    | UP        | ON        | NONE       | NA         | NA         | NA              | NA            | 3.3       
sd_dat0           | -         | 84/0          | Y          | in    | IOT6[A]  | -               | LVCMOS33   | NA    | UP        | ON        | NONE       | NA         | NA         | NA              | NA            | 3.3       
uart_tx           | -         | 69/1          | Y          | out   | IOT50[A] | -               | LVCMOS33   | 8     | UP        | NA        | NA         | OFF        | NA         | NA              | NA            | 3.3       
sd_clk            | -         | 83/0          | Y          | out   | IOT6[B]  | -               | LVCMOS33   | 8     | NONE      | NA        | NA         | OFF        | NA         | NA              | NA            | 3.3       
sd_cmd            | -         | 82/0          | Y          | out   | IOT17[A] | -               | LVCMOS33   | 8     | NONE      | NA        | NA         | OFF        | NA         | NA              | NA            | 3.3       
sd_dat1           | -         | 85/0          | Y          | out   | IOT4[B]  | -               | LVCMOS33   | 8     | NONE      | NA        | NA         | OFF        | NA         | NA              | NA            | 3.3       
sd_dat2           | -         | 80/0          | Y          | out   | IOT27[A] | GCLKT_0         | LVCMOS33   | 8     | NONE      | NA        | NA         | OFF        | NA         | NA              | NA            | 3.3       
sd_dat3           | -         | 81/0          | Y          | out   | IOT17[B] | -               | LVCMOS33   | 8     | NONE      | NA        | NA         | OFF        | NA         | NA              | NA            | 3.3       
O_sdram_clk       | -         | p73/2         | -          | out   | IOR11[B] | -               | LVTTL33    | -     | UP        | -         | -          | -          | -          | -               | -             | -         
O_sdram_cke       | -         | p18/7         | -          | out   | IOL13[A] | -               | LVTTL33    | -     | UP        | -         | -          | -          | -          | -               | -             | -         
O_sdram_cs_n      | -         | p22/7         | -          | out   | IOL14[B] | -               | LVTTL33    | -     | UP        | -         | -          | -          | -          | -               | -             | -         
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
=========================================================================================================================================================================================================================
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
