hyperswine/simple-risc/docs/evidence/2026-10-30-structural-variants/builds/raw-48/impl/pnr/sdram_test.rpt.txt

//Copyright (C)2014-2026 Gowin Semiconductor Corporation.
//All rights reserved.

1. PnR Messages

  <Report Title>: PnR Report
  <Design File>: /Users/jasonqin/Documents/GitHub/simple-risc/output/tangnano20k/structural-next-20261030/raw-48/impl/gwsynthesis/sdram_test.vg
  <Physical Constraints File>: /Users/jasonqin/Documents/GitHub/simple-risc/output/tangnano20k/structural-next-20261030/raw-48/pins.cst
  <Timing Constraints File>: /Users/jasonqin/Documents/GitHub/simple-risc/output/tangnano20k/structural-next-20261030/raw-48/clocks.sdc
  <Tool Version>: V1.9.12.04
  <Part Number>: GW2AR-LV18QN88C8/I7
  <Device>: GW2AR-18
  <Device Version>: C
  <Created Time>:Fri Oct 30 03:02:10 2026

2. PnR Details

  Running placement:
    Placement Phase 0: CPU time = 0h 0m 3s, Elapsed time = 0h 0m 3s
    Placement Phase 1: CPU time = 0h 0m 0.73s, Elapsed time = 0h 0m 0.738s
    Placement Phase 2: CPU time = 0h 0m 19s, Elapsed time = 0h 0m 20s
    Placement Phase 3: CPU time = 0h 0m 49s, Elapsed time = 0h 0m 52s
    Total Placement: CPU time = 0h 1m 12s, Elapsed time = 0h 1m 16s
 Running routing:
    Routing Phase 0: CPU time = 0h 0m 0.009s, Elapsed time = 0h 0m 0.009s
    Routing Phase 1: CPU time = 0h 0m 0.684s, Elapsed time = 0h 0m 0.711s
    Routing Phase 2: CPU time = 0h 0m 42s, Elapsed time = 0h 0m 42s
    Routing Phase 3: CPU time = 0h 0m 0s, Elapsed time = 0h 0m 0s
    Total Routing: CPU time = 0h 0m 42s, Elapsed time = 0h 0m 43s
 Generate output files:
    CPU time = 0h 0m 4s, Elapsed time = 0h 0m 4s

 Total Time and Memory Usage: CPU time = 0h 1m 58s, Elapsed time = 0h 2m 3s, Peak memory usage = 401MB

3. Resource Usage Summary

  --------------------------------------------------------------------------------
  Resources                   | Usage                               | Utilization
  --------------------------------------------------------------------------------
  Logic                       | 14153/20736                         |  69%
    --LUT,ALU,ROM16           | 14051(13146 LUT, 905 ALU, 0 ROM16)  | -
    --SSRAM(RAM16)            | 17                                  | -
  Register                    | 5307/15915                          |  34%
    --Logic Register as Latch | 0/15552                             |  0%
    --Logic Register as FF    | 5254/15552                          |  34%
    --I/O Register as Latch   | 0/363                               |  0%
    --I/O Register as FF      | 53/363                              |  15%
  CLS                         | 8474/10368                          |  82%
  I/O Port                    | 10/66                               |  16%
  I/O Buf                     | 10                                  | -
    --Input Buf               | 4                                   | -
    --Output Buf              | 6                                   | -
    --Inout Buf               | 0                                   | -
  BSRAM                       | 38/46                               | 83%
    --SDPB                    | 35
    --SDPX9B                  | 2
    --pROM                    | 1
  DSP                         | 3.5/24                              | 15%
    --MULT18X18               | 1
    --MULTADDALU18X18         | 2
    --ALU54D                  | 1
  ================================================================================

4. I/O Bank Usage Summary

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

5. Clock Resource Usage Summary

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

6. Global Clock Signals

  -------------------------------------------
  Signal         | Global Clock   | Location
  -------------------------------------------
  clk_27m_d      | PRIMARY        |  BL
  clk            | PRIMARY        |  TR TL BR BL
  O_sdram_clk_d  | PRIMARY        |  TR
  core/c$running_app_arg_2708_9| PRIMARY        |  TR BR
  advance        | LW             |  -
  memory_reset_sync[1]| LW             |  -
  core/c$running_app_arg_3431_6| LW             |  -
  core/result_214_2780_5| LW             |  -
  core/c$running_app_arg_3107_9| LW             |  -
  core/c$running_app_arg_2974_9| LW             |  -
  core/c$running_app_arg_2841_9| LW             |  -
  core/c$ds_app_arg_29[22]| LW             |  -
  ===========================================

7. Pinout by Port Name

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

8. All Package Pins

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
