hyperswine/simple-risc/docs/evidence/2026-11-08-a-to-f/synthesis/inputs/pipeline_cache.v

// Fixed three-logical-clock CPU word port, with a blocking line refill.
// The CPU wrapper owns the request register; this cache owns its two lookup
// stages, and the word selected after the BSRAM read goes straight to the
// CPU. A miss freezes the CPU and every stage together. Physical
// clocks, SDRAM refresh, and the ordered masked-write queue keep advancing.
// Address bit21 selects boot ROM; bits20:0 are full SDRAM word addresses.
module sdram_pipeline_cache #(
 parameter LINE_BITS=7, // sets per way (128 x 16-byte lines/way; 4 KiB 2-way by default)
 // 1: a store that hits updates its cached word and keeps the line valid
 // (board-verified with the banked data array, 2026-10-19).
 // 0: every store invalidates its line (the original policy).
 parameter WRITE_UPDATE=1,
 parameter WAYS=1,
 parameter ROM_FILE="boards/tangnano20k/bootrom/bootrom.hex"
)(input clk,reset,input [21:0] cpu_address,input cpu_write,
 input [31:0] cpu_wdata,input [3:0] cpu_mask,
 output hold_cpu,output [31:0] cpu_rdata,
 output memory_req,output memory_write,output [20:0] memory_address,
 output [31:0] memory_wdata,output [3:0] memory_mask,
 input memory_ready,memory_done,input [31:0] memory_rdata,
 input memory_word_valid,input [1:0] memory_word_index);
 localparam IDLE=0,WRITE_SEND=1,WRITE_WAIT=2,READ_SEND=3,READ_WAIT=4;
 reg [2:0] state;
 reg clearing;reg [LINE_BITS-1:0] clear_index;
 // The data array is banks of 512 x 32 words, one wide BSRAM each (so
 // LINE_BITS>=7). Left to itself Gowin maps a deep array to narrow slices
 // (16Kx1, 8Kx2), and on the board a single-word write to those sometimes
 // changed a bit of another word in the slice, which write-update's isolated
 // stores hit; the 512x32 mode did not (WRITE-UPDATE-2026-10-19.md).
 localparam BANKS=(1<<(LINE_BITS+2))/512,BANK_BITS=BANKS>1 ? $clog2(BANKS):1;
 // One synchronous read and one write port map each way's tag array to
 // BSRAM. Distributed tags create a broad asynchronous address mux which
 // otherwise dominates timing even though the CPU request is registered.
 reg [19-LINE_BITS:0] tags[0:(1<<LINE_BITS)-1] /* synthesis syn_ramstyle = "block_ram" */;
 reg [19-LINE_BITS:0] tags_way1[0:(1<<LINE_BITS)-1] /* synthesis syn_ramstyle = "block_ram" */;
 // One replacement bit per set, in the same kind of memory as the tags. A
// distributed lookup put the whole 2^LINE_BITS-deep asynchronous mux between
// the CPU's address and the register that holds the bit, and that was the
// design's worst path (25.2 ns from the address register at 48 MHz). A block
// RAM keeps that mux inside the hard block, so the address reaches its input
// register instead. The bit is only a replacement hint: it never affects the
// data a lookup returns, so it is also the one array where a read-during-write
// result may be discarded.
// Clearing shares the existing tag sweep, so no wide reset is needed.
 reg mru[0:(1<<LINE_BITS)-1] /* synthesis syn_ramstyle = "block_ram" */;
 // Read-through for a write that lands on the address being read, registered
 // one cycle later so the memory's own output stays a plain registered read.
 reg entry_mru_raw,entry_mru_bypass,entry_mru_write;
 wire entry_mru=entry_mru_bypass ? entry_mru_write:entry_mru_raw;
 reg [31:0] rom[0:511];
 initial $readmemh(ROM_FILE,rom);
 reg v1,v2,w1,w2,hit2,keep2,way2,conflict2,fill_way;
 reg [21:0] a1,a2;
 reg [31:0] d1,d2;
 reg [3:0] m1,m2;
 reg [19-LINE_BITS:0] entry_tag,entry_tag_way1;
 reg tag_conflict;
 reg [20:0] write_address[0:3];
 reg [31:0] write_data[0:3];reg [3:0] write_mask[0:3];
 reg [1:0] write_head,write_tail;reg [2:0] write_count;
 reg last_write,last_update;reg [21:0] last_address;reg [31:0] last_data,last_word;reg [3:0] last_mask;
 reg fill_forward;reg [18:0] fill_line;
 reg [31:0] fill_data[0:3],fill_target;
 wire read_miss=v2 && !w2 && !hit2;
 wire write_full=v2 && w2 && !a2[21] && write_count==4;
 assign hold_cpu=reset || clearing || read_miss || write_full;
 wire advance=!hold_cpu;
 wire push=advance && v2 && w2 && !a2[21];
 // A store keeps its line only when its lookup is certain: a hit whose line
 // no refill replaced in between. Under write-update, a store miss whose tag
 // lookup was clean knows its line is not cached and leaves valid lines in
 // the same set intact; a tag-collision lookup or WRITE_UPDATE=0 invalidates.
 wire update=WRITE_UPDATE!=0 && push && keep2;
 wire store_invalidate=push && ((WAYS<=1) ? !update:(WRITE_UPDATE==0 || conflict2));
 wire pop=state==WRITE_WAIT && memory_done;
 wire tag_fill=state==READ_WAIT && memory_done;
 wire tag_write=clearing || store_invalidate || tag_fill;
 wire tag_write_way0=clearing || store_invalidate || (tag_fill && !way2);
 wire tag_write_way1=clearing || store_invalidate || (tag_fill && way2);
 wire [LINE_BITS-1:0] tag_write_index=(tag_fill || push) ? a2[LINE_BITS+1:2]:clear_index;
 wire [19-LINE_BITS:0] tag_write_value=tag_fill ? {1'b1,a2[20:LINE_BITS+2]}:0;
 wire mru_write=clearing || tag_fill || (advance && v2 && hit2 && !a2[21]);
 wire [LINE_BITS-1:0] mru_index=clearing ? clear_index:a2[LINE_BITS+1:2];
 wire mru_value=clearing ? 1'b0:way2;
 wire mru_bypass=mru_write && mru_index==cpu_address[LINE_BITS+1:2];
 assign memory_req=!reset && (state==WRITE_SEND || state==READ_SEND);
 assign memory_write=state==WRITE_SEND || state==WRITE_WAIT;
 assign memory_address=memory_write ? write_address[write_head]:{a2[20:2],2'b00};
 assign memory_wdata=write_data[write_head];
 assign memory_mask=memory_write ? write_mask[write_head]:4'b1111;
 // A refill must not read SDRAM under a queued store to its own line. Other
 // queued stores may complete after the refill: they touch other lines.
 wire [3:0] same_line;
 genvar q;
 generate for(q=0;q<4;q=q+1)begin: queued_lines
   localparam [1:0] SLOT=q;
   wire [1:0] age=SLOT-write_head; // position in the queue, modulo four
   assign same_line[q]=age<write_count && write_address[q][20:2]==a2[20:2];
 end endgenerate
 wire fill_conflict=|same_line;
 wire filled=fill_forward && !a1[21] && a1[20:2]==fill_line;
 wire way0_match=entry_tag[19-LINE_BITS] && entry_tag[18-LINE_BITS:0]==a1[20:LINE_BITS+2];
 wire way1_match=(WAYS>1) && entry_tag_way1[19-LINE_BITS] && entry_tag_way1[18-LINE_BITS:0]==a1[20:LINE_BITS+2];
 wire hit1=a1[21] || filled || (!tag_conflict && (way0_match || way1_match));
 // Way 0 and Way 1 never hold duplicate valid tags (asserted below), so
 // hit_way1 needs only way1_match, avoiding an extra LUT level after BSRAM DO.
 wire hit_way1=filled ? fill_way:way1_match;
 wire same_fill_set=fill_forward && !a1[21] && a1[LINE_BITS+1:2]==fill_line[LINE_BITS-1:0];
 // Cold sets allocate Way 0 first, then Way 1, and thereafter replace !mru.
 wire victim_way1=(WAYS<=1) ? 1'b0:
   same_fill_set ? ~fill_way:
   !entry_tag[19-LINE_BITS] ? 1'b0:
   !entry_tag_way1[19-LINE_BITS] ? 1'b1:
   ~entry_mru;
 // The refill that just completed overwrote a1's way in this set: its lookup is stale.
 wire evicted=same_fill_set && !filled && hit_way1==fill_way;
 // A store invalidating the line being read may return any BRAM value.
 // Ignore that tag, preserving coherence independently of device-specific
 // read-during-write behavior. Refill completion already freezes advance.
 always @(posedge clk)begin
   if(!reset && tag_write_way0)tags[tag_write_index]<=tag_write_value;
   if(advance)entry_tag<=tags[cpu_address[LINE_BITS+1:2]];
 end
 always @(posedge clk)begin
   if(!reset && tag_write_way1)tags_way1[tag_write_index]<=tag_write_value;
   if(advance)entry_tag_way1<=tags_way1[cpu_address[LINE_BITS+1:2]];
 end
 always @(posedge clk)begin
   if(!reset && mru_write)mru[mru_index]<=mru_value;
   if(advance)begin
     entry_mru_raw<=mru[cpu_address[LINE_BITS+1:2]];
     entry_mru_bypass<=mru_bypass;entry_mru_write<=mru_value;
   end
 end
 function [31:0] merged(input [31:0] before_word,input [31:0] data,input [3:0] lanes);
 integer k;
 begin
   merged=before_word;
   for(k=0;k<4;k=k+1)if(lanes[k])merged[k*8+:8]=data[k*8+:8];
 end endfunction
 // cpu_word is the word selected for the request in A2, which the
 // write-update store path also merges into. It is the CPU's read data, so
 // the port is three logical clocks; from 2026-10-29 to 2026-11-06 a second
 // register repeated it to split the cache-to-core route, which the fprisc-81
 // floorplan now keeps short (docs/2026-11-06-THREE-CLOCK-PORT.md). It is
 // held while the CPU is frozen, so the CPU reads a stable word on the edge
 // that releases it.
 reg [31:0] cpu_word;
 assign cpu_rdata=cpu_word;
 // cpu_word holds the store's own lookup (with older stores merged), so
 // the updated word is complete even for a partial store.
 wire [31:0] store_word=merged(cpu_word,d2,m2);
 wire words_write=(state==READ_WAIT && memory_word_valid) || update;
 wire [LINE_BITS+1:0] words_index=update ? a2[LINE_BITS+1:0]:{a2[LINE_BITS+1:2],memory_word_index};
 wire [31:0] words_data=update ? store_word:memory_rdata;
 // Every bank reads cpu_address on every edge; entry_word is the word read on
 // the last advancing edge (the held copy otherwise), as the read enable
 // advance would give, with a single copy rather than one per bank.
 wire [32*BANKS-1:0] bank_word;
 genvar b;
 generate for(b=0;b<BANKS;b=b+1)begin: banks
   reg [31:0] mem[0:511] /* synthesis syn_ramstyle = "block_ram" */;
   reg [31:0] read_word;
   always @(posedge clk)begin
     if(!reset && words_write && !way2 && (words_index>>9)==b)mem[words_index[8:0]]<=words_data;
     read_word<=mem[cpu_address[8:0]];
   end
   assign bank_word[32*b+:32]=read_word;
 end endgenerate
 wire [32*BANKS-1:0] bank_word_way1;
 genvar b1;
 generate if(WAYS>1)begin: way1_storage
   for(b1=0;b1<BANKS;b1=b1+1)begin: banks_way1
     reg [31:0] mem1[0:511] /* synthesis syn_ramstyle = "block_ram" */;
     reg [31:0] read_word1;
     always @(posedge clk)begin
       if(!reset && words_write && way2 && b1==(words_index>>9))mem1[words_index[8:0]]<=words_data;
       read_word1<=mem1[cpu_address[8:0]];
     end
     assign bank_word_way1[32*b1+:32]=read_word1;
   end
 end else begin: single_way_tieoff
   assign bank_word_way1=0;
 end endgenerate
 reg advanced,read_rom;reg [31:0] rom_word,held_word;
 // The bank select is also kept one-hot, registered on the BSRAM read edge,
 // so the return path is an AND-OR of the registered BSRAM words instead
 // of a binary decode of the old read_bank register followed by a wide indexed mux. This
 // was the 72 MHz build's worst path (read_bank -> cpu_rdata). It selects
 // the same word as bank_word[32*read_bank+:32] and adds no latency.
 reg [BANKS-1:0] read_bank_hot;
 reg [31:0] way0_word,way1_word;
 integer sel;
 always @* begin
   way0_word=0;way1_word=0;
   for(sel=0;sel<BANKS;sel=sel+1)begin
     way0_word=way0_word|({32{read_bank_hot[sel]}} & bank_word[32*sel+:32]);
     way1_word=way1_word|({32{read_bank_hot[sel]}} & bank_word_way1[32*sel+:32]);
   end
 end
 wire [31:0] selected_bank_word=(WAYS>1 && hit_way1) ? way1_word:way0_word;
 wire [31:0] entry_word=!advanced ? held_word:read_rom ? rom_word:selected_bank_word;
 always @(posedge clk)begin
   advanced<=advance;held_word<=entry_word;
   read_rom<=cpu_address[21];
   read_bank_hot<=1'b1<<(cpu_address[LINE_BITS+1:0]>>9);rom_word<=rom[cpu_address[8:0]];
 end
 // Evaluate non-BSRAM overrides (a2 store, last store, refill, held, ROM) in
 // parallel from flip-flops so the late BSRAM tag/data outputs (hit_way1,
 // way0_word, way1_word) pass through only one final byte-lane 2:1 mux.
 wire hit_last=last_write && a1==last_address;
 wire hit_a2=v2 && w2 && a1==a2;
 wire base_ovr=!advanced || read_rom || filled;
 wire [3:0] last_lanes={4{hit_last}} & (last_update ? 4'b1111:last_mask);
 wire [3:0] a2_lanes={4{hit_a2}} & m2;
 wire [3:0] ovr_lanes=a2_lanes | last_lanes | {4{base_ovr}};
 reg [31:0] forwarded;
 integer fl;
 always @* begin
   forwarded=filled ? fill_data[a1[1:0]]:(!advanced ? held_word:(read_rom ? rom_word:32'bx));
   if(hit_last)forwarded=last_update ? last_word:merged(forwarded,last_data,last_mask);
   if(hit_a2)forwarded=merged(forwarded,d2,m2);
   for(fl=0;fl<4;fl=fl+1)
     if(!ovr_lanes[fl])forwarded[fl*8+:8]=selected_bank_word[fl*8+:8];
 end
 always @(posedge clk) begin
   if(reset)begin
     clearing<=1;clear_index<=0;state<=IDLE;write_count<=0;
     write_head<=0;write_tail<=0;v1<=0;v2<=0;
     hit2<=0;keep2<=0;way2<=0;conflict2<=0;fill_way<=0;
     last_write<=0;last_update<=0;fill_forward<=0;cpu_word<=0;tag_conflict<=0;
   end else begin
     if(clearing)begin
       clear_index<=clear_index+1'b1;
       if(clear_index==((1<<LINE_BITS)-1))clearing<=0;
     end
     if(advance)begin
       a1<=cpu_address;w1<=cpu_write;d1<=cpu_wdata;m1<=cpu_mask;v1<=1;
       tag_conflict<=tag_write && tag_write_index==cpu_address[LINE_BITS+1:2];
       a2<=a1;w2<=w1;d2<=d1;m2<=m1;v2<=v1;
       hit2<=hit1;keep2<=hit1 && !evicted;
       way2<=hit1 ? hit_way1:victim_way1;
       conflict2<=tag_conflict && !a1[21] && !evicted;
       cpu_word<=forwarded;
       fill_forward<=0;
       last_write<=push;last_update<=update;last_address<=a2;last_data<=d2;last_mask<=m2;last_word<=store_word;
     end
     if(push)begin
       write_address[write_tail]<=a2[20:0];write_data[write_tail]<=d2;write_mask[write_tail]<=m2;
       write_tail<=write_tail+1'b1;
       // Unified physical tags keep loader stores and instruction fetches
       // coherent. A miss drains older stores to its own line first.
     end
     if(pop)write_head<=write_head+1'b1;
     case({push,pop})
       2'b10:write_count<=write_count+1'b1;
       2'b01:write_count<=write_count-1'b1;
     endcase
     case(state)
       IDLE:if(read_miss && !fill_conflict)state<=READ_SEND;
         else if(write_count!=0)state<=WRITE_SEND;
         else if(read_miss)state<=READ_SEND;
       WRITE_SEND:if(memory_ready)state<=WRITE_WAIT;
       WRITE_WAIT:if(memory_done)state<=IDLE;
       READ_SEND:if(memory_ready)begin state<=READ_WAIT;fill_line<=a2[20:2];fill_way<=way2;end
       READ_WAIT:begin
         if(memory_word_valid)begin
           fill_data[memory_word_index]<=memory_rdata;
           if(memory_word_index==a2[1:0])fill_target<=memory_rdata;
         end
         if(memory_done)begin
           // Completion may arrive with the final beat.
           cpu_word<=(memory_word_valid && memory_word_index==a2[1:0]) ? memory_rdata:fill_target;
           hit2<=1;fill_forward<=1;state<=IDLE;
         end
       end
     endcase
   end
 end
 // Simulation-time mirrors of the cycle-level Maude safety properties. These
 // use immediate assertions for Icarus/Gowin compatibility; no hardware is
 // synthesized. The independent reference scoreboard remains the primary
 // read-data check, while these localize protocol and pipeline violations.
 // synthesis translate_off
 reg [3:0] assert_fill_seen;
 reg assert_held;
 reg [21:0] assert_a1,assert_a2;
 reg [31:0] assert_d1,assert_d2;
 reg [3:0] assert_m1,assert_m2;
 reg assert_v1,assert_v2,assert_w1,assert_w2;
 always @(posedge clk)begin
   if(reset)begin
     assert_fill_seen<=0;assert_held<=0;
   end else begin
     if(write_count>4 || write_count[1:0]!=(write_tail-write_head))
       $fatal(1,"ASSERT: posted-write queue count/pointer mismatch");
     if(state==READ_WAIT && advance)
       $fatal(1,"ASSERT: logical request/A1/A2 advanced during refill");
     if(state==READ_WAIT && (|same_line))
       $fatal(1,"ASSERT: refill overlaps a queued store to its line");
     if(memory_word_valid && state!=READ_WAIT)
       $fatal(1,"ASSERT: unexpected refill word outside READ_WAIT");
     if(state==READ_SEND)assert_fill_seen<=0;
     else if(state==READ_WAIT && memory_word_valid)begin
       if(assert_fill_seen[memory_word_index])
         $fatal(1,"ASSERT: duplicate refill beat");
       assert_fill_seen[memory_word_index]<=1;
     end
     if(state==READ_WAIT && memory_done &&
       (assert_fill_seen | (memory_word_valid ? (4'b1<<memory_word_index):4'b0))!=4'b1111)
       $fatal(1,"ASSERT: refill completed before all four beats");
     if(WAYS>1 && tag_fill)begin
       if(!way2 && tags_way1[a2[LINE_BITS+1:2]][19-LINE_BITS] &&
         tags_way1[a2[LINE_BITS+1:2]][18-LINE_BITS:0]==a2[20:LINE_BITS+2])
         $fatal(1,"ASSERT: refill duplicates a tag in Way 0 and Way 1");
       if(way2 && tags[a2[LINE_BITS+1:2]][19-LINE_BITS] &&
         tags[a2[LINE_BITS+1:2]][18-LINE_BITS:0]==a2[20:LINE_BITS+2])
         $fatal(1,"ASSERT: refill duplicates a tag in Way 0 and Way 1");
     end
     if(assert_held &&
       (a1!==assert_a1 || a2!==assert_a2 || d1!==assert_d1 || d2!==assert_d2 ||
        m1!==assert_m1 || m2!==assert_m2 || v1!==assert_v1 || v2!==assert_v2 ||
        w1!==assert_w1 || w2!==assert_w2))
       $fatal(1,"ASSERT: request/A1/A2 changed while held");
     assert_held<=hold_cpu;
     assert_a1<=a1;assert_a2<=a2;assert_d1<=d1;assert_d2<=d2;
     assert_m1<=m1;assert_m2<=m2;assert_v1<=v1;assert_v2<=v2;
     assert_w1<=w1;assert_w2<=w2;
   end
 end
 // synthesis translate_on
endmodule
