hyperswine/simple-risc/boards/tangnano20k/sdram/check_pipeline_cache.py

#!/usr/bin/env python3
"""Exercise the three-stage cache port and undefined BSRAM collisions.

The fixture compares reads and every ordered masked write with an independent
RAM model. Simulation-only source copies return X for same-address tag RAM
and data RAM read/write collisions, as physical BSRAM is allowed to do. The
production guards (the tag collision flag, and forwarding the whole word an
updating store wrote) must keep all replies correct; removing either must fail.
"""
import argparse
import hashlib
import json
from pathlib import Path
import subprocess

HERE = Path(__file__).resolve().parent
ROOT = HERE.parents[2]


def digest(text):
    return hashlib.sha256(text.encode()).hexdigest()


def main():
    parser = argparse.ArgumentParser(description=__doc__)
    parser.add_argument('--out', type=Path, default=ROOT/'output/tangnano20k/pipeline-cache-regression')
    args = parser.parse_args()
    out = args.out.resolve();out.mkdir(parents=True, exist_ok=True)
    source = (HERE/'pipeline_cache.v').read_text()
    fixture = (HERE/'pipeline_cache_tb.v').read_text()
    results = []

    def run(name, rtl, tb, expected=0, failure='undefined tag collision used as a hit',
            banks=False, line_bits=12, ways=1):
        rtl_path = out/(name+'.v');rtl_path.write_text(rtl)
        tb_path = out/(name+'-tb.v');tb_path.write_text(tb)
        executable = out/(name+'-sim')
        command = ['iverilog', '-g2012', '-s', 'pipeline_cache_tb', '-o', str(executable), str(rtl_path), str(tb_path)]
        command[1:1] = ['-P', f'pipeline_cache_tb.WAYS={ways}']
        if banks:
            command[1:1] = ['-P', f'pipeline_cache_tb.LINE_BITS={line_bits}',
                            '-P', 'pipeline_cache_tb.BANK_SWEEP=1']
        compiled = subprocess.run(command, cwd=ROOT, capture_output=True, text=True, timeout=60)
        if compiled.returncode:
            raise AssertionError(compiled.stdout+compiled.stderr)
        executed = subprocess.run(['vvp', str(executable)], cwd=ROOT, capture_output=True, text=True, timeout=120)
        text = executed.stdout+executed.stderr
        (out/(name+'.log')).write_text(text)
        if executed.returncode != expected:
            raise AssertionError(f'{name}: exit {executed.returncode}\n{text}')
        if expected == 0:
            bank_count = 1 << (line_bits-7)
            expected_pass = (f'PASS: {241+8*bank_count} reads, {137+2*bank_count} ordered masked writes'
                             if banks else 'PASS: 241 reads, 137 ordered masked writes')
            assert expected_pass in text, text
        else:
            assert failure in text, text
        results.append({'name': name, 'passed': True, 'expected_exit': expected,
                        'rtl_sha256': digest(rtl), 'testbench_sha256': digest(tb), 'output': text})
        (out/'results.json').write_text(json.dumps({'complete': False, 'cases': results}, indent=2)+'\n')
        print(f'{name}: PASS', flush=True)

    # Write-update is the default; the original invalidating policy keeps
    # its own run.
    default_policy = 'parameter WRITE_UPDATE=1,'
    assert source.count(default_policy) == 1
    updating = source
    run('normal-write-update', updating, fixture)
    invalidating = source.replace(default_policy, 'parameter WRITE_UPDATE=0,')
    run('normal-invalidate', invalidating, fixture)
    two_way_updating = updating.replace('parameter WAYS=1,', 'parameter WAYS=2,')
    run('two-way-write-update', two_way_updating, fixture, ways=2)
    assert '23 line fills' in results[-1]['output'], results[-1]['output']
    two_way_invalidating = invalidating.replace('parameter WAYS=1,', 'parameter WAYS=2,')
    run('two-way-invalidate', two_way_invalidating, fixture, ways=2)
    run('all-32-banks-write-update', updating, fixture, banks=True)
    run('all-32-banks-invalidate', invalidating, fixture, banks=True)
    run('all-16-banks-two-way-write-update', two_way_updating, fixture,
        banks=True, line_bits=11, ways=2)
    run('all-16-banks-two-way-invalidate', two_way_invalidating, fixture,
        banks=True, line_bits=11, ways=2)
    bank_guard = '(words_index>>9)==b'
    assert source.count(bank_guard) == 1
    run('missing-bank-write-select', source.replace(bank_guard, "1'b1"), fixture,
        expected=1, failure='reply', banks=True)
    way1_bank_guard = 'b1==(words_index>>9)'
    assert source.count(way1_bank_guard) == 1
    run('missing-way1-bank-write-select', two_way_updating.replace(way1_bank_guard, "1'b1"), fixture,
        expected=1, failure='reply', banks=True, line_bits=11, ways=2)
    read = 'if(advance)entry_tag<=tags[cpu_address[LINE_BITS+1:2]];'
    poisoned_read = "if(advance)entry_tag<=(tag_write && tag_write_index==cpu_address[LINE_BITS+1:2]) ? {(20-LINE_BITS){1'bx}}:tags[cpu_address[LINE_BITS+1:2]];"
    assert source.count(read) == 1, 'update the collision injection for the current tag read port'
    # Every invalidating store writes a tag: the most tag collisions.
    poisoned = invalidating.replace(read, poisoned_read)
    declaration = 'integer delay=0,'
    coverage = '''integer collisions=0;
 always @(posedge clk)if(!reset && cache.tag_conflict && !cache.a1[21])begin
   if(cache.advance)collisions=collisions+1;
   if(!cache.filled && cache.hit1!==1'b0)$fatal(1,"undefined tag collision used as a hit");
 end
 integer delay=0,'''
    finish = '$display("PASS: %0d reads,'
    checked_finish = '''if(collisions==0)$fatal(1,"tag collision poisoning was not exercised");
       $display("PASS: %0d logical tag collisions ignored",collisions);
       $display("PASS: %0d reads,'''
    assert fixture.count(declaration) == 1 and fixture.count(finish) == 1
    checked = fixture.replace(declaration, coverage).replace(finish, checked_finish)
    run('tag-collision-poison', poisoned, checked)
    guard = '!tag_conflict && '
    assert poisoned.count(guard) == 1
    run('missing-collision-guard', poisoned.replace(guard, ''), checked, expected=1)
    # A store that hits writes its word on the same edge as the next lookup.
    word_read = "read_word<=mem[cpu_address[8:0]];"
    poisoned_word_read = ("read_word<=(words_write && words_index==cpu_address[LINE_BITS+1:0]) ? 32'bx:"
                          "mem[cpu_address[8:0]];")
    assert updating.count(word_read) == 1, 'update the collision injection for the current data read port'
    word_poisoned = updating.replace(word_read, poisoned_word_read)
    word_coverage = '''integer word_collisions=0;
 always @(posedge clk)if(!reset && cache.advance && cache.words_write && cache.update &&
   cache.words_index==cache.cpu_address[LINE_BITS_TB+1:0] && !cache.cpu_address[21])word_collisions=word_collisions+1;
 integer delay=0,'''.replace('LINE_BITS_TB', '7')
    word_finish = '''if(word_collisions==0)$fatal(1,"data collision poisoning was not exercised");
       $display("PASS: %0d data read/write collisions forwarded",word_collisions);
       $display("PASS: %0d reads,'''
    word_checked = fixture.replace(declaration, word_coverage).replace(finish, word_finish)
    run('data-collision-poison', word_poisoned, word_checked)
    word_guard = 'last_update ? last_word:merged(forwarded,last_data,last_mask)'
    assert word_poisoned.count(word_guard) == 1
    run('missing-data-forward', word_poisoned.replace(word_guard, 'merged(forwarded,last_data,last_mask)'),
        word_checked, expected=1, failure='reply')
    # The fixture's backend sometimes completes with the final beat, as the
    # clock bridge does: the reply must then take that beat directly.
    capture = 'cpu_word<=(memory_word_valid && memory_word_index==a2[1:0]) ? memory_rdata:fill_target;'
    assert source.count(capture) == 1
    run('missing-final-beat-capture', source.replace(capture, 'cpu_word<=fill_target;'), fixture,
        expected=1, failure='reply')
    # Assertion negative controls mirror the Maude refill/queue guards and
    # prove that the four-beat protocol checks are exercised, not vacuous.
    drain_guard = 'wire fill_conflict=|same_line;'
    assert invalidating.count(drain_guard) == 1
    run('assert-missing-same-line-drain',
        invalidating.replace(drain_guard, "wire fill_conflict=1'b0;"), fixture,
        expected=1, failure='ASSERT: refill overlaps a queued store to its line')
    last_beat_done = 'if(phase==4 && tick%2==0)begin done<=1;phase<=0;end'
    assert fixture.count(last_beat_done) == 1
    early_done = fixture.replace(last_beat_done,
        'if(phase==3 && tick%2==0)begin done<=1;phase<=0;end')
    run('assert-incomplete-refill', updating, early_done,
        expected=1, failure='ASSERT: refill completed before all four beats')
    advance_beat = 'mrdata<=ram[saved_address+phase-1];beat<=phase-1;valid<=1;phase<=phase+1;'
    assert fixture.count(advance_beat) == 1
    duplicate_beat = fixture.replace(advance_beat,
        "mrdata<=ram[saved_address+phase-1];beat<=phase-1;valid<=1;phase<=phase==2 ? phase:phase+1;")
    run('assert-duplicate-refill-beat', updating, duplicate_beat,
        expected=1, failure='ASSERT: duplicate refill beat')
    (out/'results.json').write_text(json.dumps({'complete': True,
        'source_sha256': digest(source), 'fixture_sha256': digest(fixture), 'cases': results}, indent=2)+'\n')


if __name__ == '__main__':
    main()
