hyperswine/simple-risc/boards/tangnano20k/sdram/preset_manifest.py

#!/usr/bin/env python3
"""Record a fresh preset build; incomplete builds never become loadable.

The preset is SDRAM_PRESET (fprisc-48 when unset, for the older callers)."""
import hashlib
import json
import os
from pathlib import Path
import subprocess
import sys

ROOT = Path(__file__).resolve().parents[3]
CONFIG = dict(xlen=32, compressed=True, cpu_mhz=48, memory_mhz=48,
              ram_bytes=8388608, cache_bytes=65536, cache_ways=1,
              cache_line_bits=12, phase_degrees=135,
              placement=2, write_update=True)
# The faster image: the CPU on its own clock behind the bridge, and the build
# options that place it with margin at 72 MHz (see preset.sh). With the
# three-clock cache port it routes only with the floorplan, so it takes
# fprisc-81's plan and placement (docs/2026-11-06-THREE-CLOCK-PORT.md).
CONFIG_72 = dict(xlen=32, compressed=True, cpu_mhz=72, memory_mhz=48,
                 ram_bytes=8388608, cache_bytes=65536, cache_ways=2,
                 cache_line_bits=11, phase_degrees=135,
                 placement=3, write_update=True, placer_target_mhz=79,
                 map_option=3, route_option=1, route_maxfan=8,
                 floorplan='fprisc-81.plan')
# The 81 MHz image: the RV32IM core since 2026-11-08 (docs/2026-11-08-IM-CANON.md),
# which closes 81 MHz at every placement option with the fprisc-81.plan
# floorplan; the IMC core closed only at placements 0 and 3
# (docs/2026-11-06-THREE-CLOCK-PORT.md, docs/2026-11-08-IM-ONLY-BUILD.md).
CONFIG_81 = dict(xlen=32, compressed=False, cpu_mhz=81, memory_mhz=48,
                 ram_bytes=8388608, cache_bytes=65536, cache_ways=2,
                 cache_line_bits=11, phase_degrees=135,
                 placement=3, write_update=True, placer_target_mhz=89,
                 map_option=3, route_option=1, route_maxfan=8,
                 floorplan='fprisc-81.plan')
# The fprisc-81 shape at 84 MHz, the highest clock the IM core closes at
# every placement option (docs/2026-11-08-FPRISC-84.md).
CONFIG_84 = dict(CONFIG_81, cpu_mhz=84, placer_target_mhz=92)
PRESETS = {'fprisc-48': CONFIG, 'fprisc-72': CONFIG_72, 'fprisc-81': CONFIG_81, 'fprisc-84': CONFIG_84}


def preset():
    name = os.environ.get('SDRAM_PRESET') or 'fprisc-48'
    if name not in PRESETS:
        raise SystemExit(f'unknown SDRAM_PRESET: {name}')
    return name


def sha(path):
    return hashlib.sha256(path.read_bytes()).hexdigest()


def inputs():
    paths = list((ROOT / 'src').rglob('*.hs'))
    paths += list((ROOT / 'boards/tangnano20k/sdram').glob('*.v'))
    paths += list((ROOT / 'boards/tangnano20k/sdram').glob('*.plan'))
    paths += [ROOT / name for name in (
        'cabal.project', 'cabal.project.freeze', 'simple-risc.cabal', 'bin/Clash.hs',
        'boards/tangnano20k/tangnano20k.cst', 'boards/tangnano20k/bootrom/bootrom.hex',
        'boards/tangnano20k/bootrom/bootrom-sdram.hex',
        'boards/tangnano20k/sdram/build.sh', 'boards/tangnano20k/sdram/preset.sh',
        'boards/tangnano20k/sdram/preset_manifest.py',
        'boards/tangnano20k/sdram/floorplan_cst.py',
        'boards/tangnano20k/sdram/area_census.py',
        'boards/tangnano20k/sdram/path_census.py',
        'tools/PipelineLayout.hs',
        'boards/tangnano20k/sdram/io_timing.py',
        'boards/tangnano20k/sdram/io_timing_gw2ar18_qn88.json',
        'boards/tangnano20k/check_gowin_timing.py')]
    return {str(p.relative_to(ROOT)): sha(p) for p in sorted(paths)}


def compute_build_id(input_hashes, config=CONFIG):
    payload = json.dumps({'configuration': config, 'inputs': input_hashes}, sort_keys=True).encode()
    return hashlib.sha256(payload).hexdigest()[:16]


def rom_identity(input_hashes, config=CONFIG):
    return dict(
        protocol='SRID1',
        isa='rv32imc' if config.get('compressed') else 'rv32im',
        cpu_mhz=config['cpu_mhz'],
        mem_mhz=config['memory_mhz'],
        ram_bytes=config['ram_bytes'],
        max_bytes=2097152,
        capabilities='PMXQVHTUICG',
        build_id=compute_build_id(input_hashes, config),
    )


def main():
    action, directory = sys.argv[1:3]
    name = preset()
    config = PRESETS[name]
    out = Path(directory).resolve()
    out.mkdir(parents=True, exist_ok=True)
    manifest = out / 'build-manifest.json'
    if action == 'begin':
        # Even missing tools or unreadable source inputs must invalidate an
        # earlier success before the new build's provenance is collected.
        manifest.write_text(json.dumps(dict(preset=name, ready=False)) + '\n')
        inp = inputs()
        report = dict(preset=name, configuration=config,
                      rom_identity=rom_identity(inp, config), ready=False,
                      qualification='internal STA only; SDRAM I/O/PVT unqualified',
                      source_root=str(ROOT), inputs=inp,
                      revision=subprocess.check_output(['git', 'rev-parse', 'HEAD'], cwd=ROOT, text=True).strip(),
                      source_diff_sha256=hashlib.sha256(subprocess.check_output(['git', 'diff', 'HEAD'], cwd=ROOT)).hexdigest(),
                      tools={tool: subprocess.check_output(command, cwd=ROOT, text=True).strip()
                             for tool, command in {'ghc': ['ghc-9.8.2', '--numeric-version'],
                                                   'cabal': ['cabal', '--numeric-version']}.items()})
    elif action == 'finish':
        report = json.loads(manifest.read_text())
        if report.get('preset', name) != name:
            raise SystemExit(f"manifest records {report.get('preset')}, not {name}")
        if report['inputs'] != inputs():
            raise SystemExit('preset inputs changed during build; rebuild before loading')
        if 'rom_identity' not in report:
            report['rom_identity'] = rom_identity(report['inputs'], config)
        # Repeat the gate here so invoking this helper alone cannot mark a
        # failed placement ready. Hash the checked report and final bitstream.
        timing = out / 'impl/pnr/sdram_test.tr'
        clocks = ['--freq-mhz', str(config['cpu_mhz'])]
        if config['memory_mhz'] != config['cpu_mhz']:
            clocks += ['--memory-freq-mhz', str(config['memory_mhz'])]
        subprocess.run([sys.executable, str(ROOT / 'boards/tangnano20k/check_gowin_timing.py'),
                        str(timing), *clocks], check=True)
        artifacts = {}
        for name in ('impl/pnr/sdram_test.fs', 'impl/pnr/sdram_test.tr',
                     'pipeline_top.v', 'pll.v', 'clocks.sdc', 'build.tcl', 'pins.cst'):
            path = out / name
            if not path.stat().st_size:
                raise SystemExit(f'empty build artifact: {path}')
            artifacts[name] = sha(path)
        rtl = Path(sys.argv[3]).resolve()
        report.update(ready=True, artifacts=artifacts,
                      rtl={'path': str(rtl), 'sha256': sha(rtl)})
    else:
        raise SystemExit('expected begin or finish')
    manifest.write_text(json.dumps(report, indent=2) + '\n')


if __name__ == '__main__':
    main()
