hyperswine/simple-risc/docs/evidence/2026-11-08-a-to-f/synthesis/inputs/dual_pll.v

// Independent PLLs default to the tested 54 MHz controller / 135-degree SDRAM
// clock relationship while running the CPU/cache at 72..96 (in 3 MHz steps) or
// 108 MHz, and also support 48 MHz SDRAM (e.g. 96/48, 90/48, 84/48, 81/48, 72/48).
// The CPU VCO is 576..864 MHz (8 x CPU_MHZ); the memory VCO is 864 or 768 MHz.
// build.sh can generate another SDRAM phase for controlled experiments. The
// mailbox treats PLL phase as unrelated.
module sdram_dual_pll #(parameter CPU_MHZ=108,parameter MEM_MHZ=54)(
 input clk_27m,output clk_core,clk_memory,clk_sdram,pll_lock);
 wire cpu_lock,memory_lock;
 sdram_pll #(.FBDIV_SEL(CPU_MHZ/3-1),.ODIV_SEL(8)) cpu(
  .clk_27m(clk_27m),.clk_core(clk_core),.clk_sdram(),.pll_lock(cpu_lock));
 sdram_pll #(.FBDIV_SEL(MEM_MHZ/3-1),.ODIV_SEL(16)) memory(
  .clk_27m(clk_27m),.clk_core(clk_memory),.clk_sdram(clk_sdram),.pll_lock(memory_lock));
 assign pll_lock=cpu_lock && memory_lock;
endmodule
