hyperswine/simple-risc/(commit log)

2026-04-14 CPURISC: Test UART
2026-04-30 CPURISCV: Fix Core Logic Stalls
2026-09-04 UART: Tests + Format
2026-09-13 Fixes: Loop + UART drop issue + RX + 2->1 cycle
2026-09-13 Test: Refactor stepSim, add runUntilHalt, and implement instruction encoders
2026-09-21 100-Register-Device: Implement
2026-09-22 100-Register-Driver: Fix Timing and LUT Usage.
2026-10-04 SimpleRisc: RV32M, 64 KiB RAM, C runtime and program loader
    - Add the M extension (MUL, MULH, MULHSU, MULHU, DIV, DIVU, REM, REMU) as an
    iterative unit, about 36 cycles per instruction with one 33-bit add or
    subtract per cycle; division by zero and overflow follow the RISC-V spec.
    - Grow the unified memory from 4 KiB to 64 KiB (16384 words); PROGRAM
    accepts up to 16384 words and RESET-MEM takes 16384 cycles.
    - Tests: the simulator's memory is a sparse map; a 400-case property checks
    every M instruction against an Integer reference, edge cases included.
    - boards/tangnano20k/c: crt0, link script and UART driver for rv32im C
    programs built with riscv64-unknown-elf-gcc (no libc, no lib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
2026-10-05 Start SimpleRisc machine mode with precise staged exceptions
2026-10-05 Add explicit finisher and registered device selection at 96 MHz
2026-10-06 Stage SimpleRisc execution and validate Gowin timing at 108 MHz
2026-10-06 Add serial RV64IM SDRAM core and UART loader checks
2026-10-11 SimpleRisc: boot ROM at 0, RAM at 0x80000000 (roadmap step 3)
    The CPU is only a CPU now. A 572-byte boot ROM (boards/tangnano20k/bootrom,
    embedded at compile time from bootrom.hex) implements the unchanged P/R/M/X
    host protocol in software, loads and starts programs at 0x80000000 with mret,
    and sends DONE after a finisher exit or a trap taken with mtvec 0. A new
    read-only BOOTCAUSE register (0x00100004) tells it why it was entered; P
    writes a zero word after each image so running off the end still traps.
    Removed from the core: the hardware host controller, the DONE sender,
    cpuRunning, programEnd, the end-of-image halt and the mtvec 0 halt rule.
    Fetching outside ROM and RAM raises an instruc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
2026-10-11 SimpleRisc: timer, interrupts, microSD and PPP (roadmap step 2)
    Interrupts (step 2):
    - CLINT at 0x0200_0000 (QEMU virt layout); mtime counts core clocks and
    keeps counting through SDRAM waits.
    - Minimal PLIC at 0x0c00_0000 with the UART as IRQ 10; UART CTRL at
    0x1000_000c enables receive and transmit-ready interrupts.
    - Software, timer and external interrupts are taken at Fetch from
    registered pending bits, mie and MIE (external > software > timer).
    - mip reads the pending bits; WFI waits for mie & mip.
    - Resets and the boot ROM's R quieten every source.
    - Gowin: BRAM 96.474 MHz with placement mode 1; SDRAM 72.073 MHz at 66.
    microSD and PPP:
    - A mode-0 SPI master at 0x1000_1000 drives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
2026-10-11 SimpleRisc: UART FIFOs, an I/O port and SPI DMA
    The first steps toward a pipelined core with I/O as a black box:
    - 16-byte transmit and 32-byte receive FIFOs. A TX store completes once
    there is room; a breaking Ctrl-C flushes unread input.
    - An I/O port: word accesses to 0x1000_1xxx wait in BusIo for the I/O
    complex outside the CPU. The complex reads the request from registered
    bus state and answers from a register a cycle later. The SPI master moved
    there.
    - SPI DMA on the RAM's second port (now a true dual-port block RAM): it
    receives after an SD start token, or sends, a byte count between SPI and
    RAM.
    - c/sd.c uses DMA for aligned blocks: a block read drops from 96,908 to
    4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
2026-10-11 Add an RV32IM reference model and differential testing
    test/Rv32Model.hs is an independent RV32IM+Zicsr interpreter. The new
    property runs random programs on the cycle-accurate core and on the model,
    and compares registers, trap CSRs, scratch, mie, touched RAM and retired
    instruction counts:
    - forward control flow, back-to-back dependencies, loads and stores with
    some misaligned and faulting addresses;
    - CSRs, including illegal accesses.
    900 programs agree, across every trap kind. It found no core bug; its three
    early mismatches were model and harness gaps. This is the safety net for
    pipelining. Report: REFERENCE-MODEL-2026-10-12.md.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
2026-10-11 Differential tests: loops, software interrupts and MRET
    The model gains the CLINT's msip, the machine software interrupt (taken at
    the next instruction boundary) and MRET. Each generated program gets:
    - a prologue that installs a trap handler;
    - a handler that returns from interrupts with MRET and records the first
    exception;
    - bounded loops, msip raises and interrupt enables.
    900 programs agree; about 20% take interrupts and 35% run loops.
2026-10-11 SimpleRisc: fetch overlap (pipeline step 1)
    Decode reads the word at pc + 4 while the RAM port is idle and keeps it in
    a prefetch buffer; a matching Fetch goes straight to Decode, saving three
    cycles.
    - Redirects simply miss.
    - A store into the buffered word invalidates it.
    - Reset drops it.
    - The SDRAM image keeps it off.
    CPI on the board's four kernels: 12.98 to 10.42 (1.25x) at the same
    96 MHz (Gowin 96.393 MHz, +0.042 ns). All suites, PPP, SD and FP-RISC's
    harness pass; 900 random programs match the reference model. Adds c/cpi.c
    and run_cpi.py to track CPI. Report: FETCH-OVERLAP-2026-10-12.md.
2026-10-11 SimpleRisc: RAM load/store fast path (pipeline step 2)
    Aligned loads and stores to the local block RAM skip the registered bus:
    - ExecuteFinish issues the word's read (a 16-bit RAM compare decides);
    - a word store writes at Commit;
    - a load or sub-word store finishes in MemoryWait/MemoryCapture, three
    cycles later.
    Faults, devices, ROM data and the SDRAM image keep the bus path. A
    first-instruction load takes 11 cycles, a word store 9.
    Memory-copy CPI on the board: 8.99 to 6.83; all four kernels 10.42 to 9.85
    (12.98 serial). Gowin 96.099 MHz (+0.011 ns, placement 1). All suites, PPP,
    SD and FP-RISC pass; 900 random programs match the reference model.
    Report: FAST-MEMORY-2026-10-12.md.
    Co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
2026-10-11 SimpleRisc: branch-target prefetch (pipeline step 3)
    ExecuteFinish of a branch or jump reads its target into a second buffer; a
    taken jump's Fetch finds it, or takes it off the bus a cycle later
    (FetchTargetWait): 2 fetch cycles instead of 4.
    Back to 96 MHz (96.008, +0.001 ns, placement 2):
    - read choice from registered kind bits;
    - a registered fetch source instead of address compares at Fetch;
    - store-into-buffer hits precomputed at ExecuteFinish from word addresses
    instead of snooping writes.
    Also: CSR instructions set the fetch source (check_counters caught the
    miss).
    Board CPI, four kernels: 9.85 to 9.56 (12.98 serial). All suites, PPP, SD
    and FP-RISC pass; 900 random programs match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
2026-10-11 SimpleRisc: decode-ahead overlap; MISC-MEM decoding fix
    Decode-ahead: at ExecuteFinish of a plain ALU instruction, the next word
    (on the bus or in the prefetch buffer) is captured. If it does not read
    this instruction's result and no interrupt is due, Commit decodes it and it
    continues at OperandSelect, skipping Fetch and Decode. Independent ALU
    instructions take 4 cycles instead of 6.
    Board CPI 9.56 to 8.82 (four kernels), but only 90 MHz meets timing
    (90.160, +0.020 ns): +1.6% instructions per second against main at 96 MHz.
    The register-file multiplexers are the limit. Kept off main.
    Fix (found by the differential test): reserved MISC-MEM encodings were
    treated as FENCE. Now FENCE is a n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
2026-10-12 SimpleRisc: register file in RAM (two asyncRam read ports)
    The BRAM circuit keeps x1-x31 in two RAMs written together, read at the
    instruction's rs1/rs2. Decode registers the outputs, so the 4-bank split
    and the bank select are gone. A 32-bit valid mask replaces clearing on
    reset. Simulation and the SDRAM image keep cpuRegs as a mirror. Gowin maps
    the RAMs to two SDPB block RAMs.
    1,009 fewer registers and 1,441 fewer logic cells. Fmax is unchanged
    (about 91 MHz best at a 96 MHz target): the critical path is now the
    state machine's muxes. At 90 MHz, RV32I and the processor suite pass on
    the board, CPI unchanged.
2026-10-12 Decode the commit kind into the stage register
    Commit, and ExecuteFinish's result choice, select from registered
    one-hot control decoded at OperandSelect instead of comparing opcode and
    funct3 bits of the instruction word.
2026-10-12 Docs: stage registers step 1; 99 MHz verified on the board
2026-10-12 Memory port: read address and store write from registers
    The CPU's port address and write come from functions of registered state
    (portAddress, portWrite) outside the phase case. A read nobody waits for
    reads the pc, so no phase needs a no-read case. Stores are prepared at
    ExecuteFinish: the RAM word index, the data in its byte lanes and the
    lane mask, so a word store writes at Commit and a byte or halfword store
    merges at MemoryCapture with two levels of logic. The prefetch word is
    captured whenever its read arrives; a fetch fault only picks Decode's
    next phase.
2026-10-12 A real pipeline for ordinary instructions
    Fetch with up to four words outstanding, decode and register read with
    forwarding, two execute stages and a commit stage run ALU instructions,
    jumps, branches and aligned RAM loads and stores. Everything else, and
    any interrupt, hands over at the commit stage: the pipeline is flushed
    and the phases run that instruction from Fetch, then the pipeline takes
    over again. The BRAM image runs this way; a second differential test
    checks it against the reference model.
2026-10-12 Pipeline control from registers
    Stall and port decisions read stage registers only: a load or sub-word
    store in the second execute stage reserves the port whether or not it
    moves; the commit stage stalls on its own wait count; fetch issues
    against the registered queue and in-flight count. The fetch queue is a
    ring whose slot is written unconditionally.
2026-10-12 Pipeline: registered read indices, interrupt flag and fetch occupancy
    The register file reads at registered indices (the next state's
    registerReads); the pipeline hands over on a registered interrupt flag;
    fetch issues against a registered count of queued and in-flight words;
    words arrive predecoded with the source registers they read; a taken
    branch fetches its target from the next cycle; flushes keep the queue's
    contents.
2026-10-12 Pipeline: read the register file for the entering word
    The register file is read at the sources of the word that would enter
    decode next (the queue head, else the arriving word), so no stall
    decision reaches its read address. Decode keeps its operands: the file's
    output on its first cycle, then held and refreshed by forwarding. The
    simulation reads at the registered indices when pipelined, so the
    differential test checks the circuit's timing.
2026-10-12 Pipeline: register the redirect; flushes clear only valid bits
    A taken branch or jump sets pRedirect as it leaves the second execute
    stage; the next cycle flushes the younger stages and fetches the target
    from the register. Restarting the pipeline changes only valid bits,
    pointers and the fetch pc.
2026-10-12 Pipeline: read indices and start from registers alone
    With the pipeline, the phases' next register read is Decode's sources,
    taken from the word FetchWait captures, else the instruction register;
    the pipeline starts on the registered interrupt flag. The fetch queue is
    empty when its pointers are equal.
2026-10-12 The read address does not wait on a break
    A Ctrl-C break cancels the cycle's memory write and UART byte; the read
    address is a don't-care then, so it no longer depends on the break.
2026-10-13 Multiply in the pipeline
    MUL, MULH, MULHSU and MULHU run in the pipeline: the first execute stage
    forms four 17 x 17 partial products of the 33-bit extended operands (DSP
    blocks), the second sums them and picks the half. Division stays in the
    phases. MULH shares SLL's funct3, so a multiply is never treated as a
    shift. A property checks the multiplier against exact arithmetic.
2026-10-13 Pipeline: forward from the second execute stage
    An ALU result other than a shift or a multiply, LUI, AUIPC or a jump's
    link is selected in the second execute stage; decode takes it from
    there, so a dependent instruction waits one cycle instead of two.
2026-10-13 Pipeline: a branch target buffer
    Eight entries indexed by pc bits 4..2: fetch looks up the pc it issues
    and fetches a hit's target next. Each instruction carries its predicted
    successor; the second execute stage redirects when the real one differs.
    A taken branch or jump writes its entry, a branch not taken clears it.
2026-10-13 The pipeline is the only datapath on the BRAM image
    Every instruction runs through the pipeline to its commit stage. There
    an interrupt, an exception or an action (a CSR access, MRET, WFI,
    division, a load or store outside RAM) flushes the pipeline and runs in
    the phases straight from the stage's registers: Trap, CsrRead and
    CsrWrite, TrapReturn, Commit (WFI), MulDiv, BusWait. FENCE.I commits and
    refetches. The circuit uses pipelinedCpuStep directly, so the phases'
    fetch, decode, operand, ALU and shift stages are not part of it. Two
    CSR reads are now 11 clocks apart.
2026-10-13 Branch prediction does not wait on the commit action
    Training the branch target buffer and redirecting fetch no longer depend
    on the second execute stage's classification: an instruction that leaves
    for the phases flushes the pipeline at commit, and a wrong entry only
    costs a redirect.
2026-10-13 Multiply from the second execute stage's operands; sum at commit
    Gowin placed the first execute stage's operand registers inside the
    multipliers, so decode's forwarding ran across the die to the DSP
    blocks. The partial products now come from the second execute stage's
    registers, and the commit stage sums them (a multiply's result is no
    longer forwarded from the commit stage).
2026-10-13 Docs and tests: interrupts are transparent; the single datapath at 78 MHz
    Two properties run the same random program undisturbed and with software
    interrupts raised at random cycles, on the phases and on the pipeline,
    and require the same registers and memory.
2026-10-13 Build with cabal alone
    haskplayground.cabal is written by hand now (common stanzas for the
    shared dependencies and warnings; the same seven components) and
    package.yaml, stack.yaml and stack.yaml.lock are gone. cabal.project
    pins GHC 9.8.2, Hackage's index to the stack snapshot's date and keeps
    allow-newer; cabal.project.freeze pins every version, identical to what
    stack resolved. A clash executable (bin/Clash.hs) replaces stack exec
    --package clash-ghc: the board build scripts run cabal run clash, which
    finds the project's packages through the GHC environment file
    cabal.project writes. The generated SimpleRisc Verilog is byte-for-byte
    the same; every test passes.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
2026-10-14 Tests: fix three flaky SimpleRisc random-program properties
    None was a core bug; each was the test or the reference model.
    - Generator: an auipc/jalr pair could jump one word past the final ECALL,
    into the trap handler, whose path depends on mcause (which interrupts
    change): its target now reaches at most the ECALL. Loop bodies generate
    each instruction for where it lands (a jump pair is two words).
    - Drain: when the branch target buffer predicted a jump into the ROM, ROM
    instructions were already in flight and could commit during the 3-cycle
    drain. `settled` squashes them, as a misprediction would, before draining.
    - Reference model: it stopped at any pc below RAM, where the core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
2026-10-18 Connect SD SPI to the SDRAM SimpleRisc pipeline
2026-10-18 SDRAM pipeline: split CPU/SDRAM clocks at 72/54 MHz; I/O audit and phase sweep
    A one-request mailbox crosses from the CPU/cache clock to the memory clock,
    with two PLLs. RV32IMC at 72 MHz CPU / 54 MHz SDRAM passes vendor timing
    (+0.003 ns) and all 12 physical FP-RISC/SD cases; 108/54 MHz fails. The
    frontend registers raw assembly and expansion separately, cache tags move
    to BSRAM with a collision guard, multiply gets an extra M cycle and
    forwarding comes from registered results.
    The SDRAM I/O audit adds a sourced timing model and a strict gate (the QN88
    profile is still incomplete; a vendor request is pending). The physical
    54 MHz phase sweep passes 90-157.5 degrees and fails every other st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
2026-10-18 SDRAM pipeline: 64 KiB cache and a FIFO clock bridge, 2.33x faster
    A Verilator harness (perf_tb.v, run_perf.py) runs a preloaded image on the
    generated CPU, the real cache, bridge, burst controller and an SDRAM pin
    model, and counts cache holds; it matches the board within 1.4%. The 72/54
    MHz image was held 71% of the time on misses: 125 KiB of code thrashed the
    2 KiB cache and each refill took 25.7 CPU clocks through the mailbox.
    - SDRAM_CACHE_LINE_BITS selects the cache size; the default is now 64 KiB.
    - A refill drains only queued stores to its own line.
    - The cache accepts completion with the final refill beat.
    - The clock bridge is a four-entry asynchronous FIFO with Gray pointers and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
2026-10-19 SimpleRisc: riscv-arch-test under RISCOF with Spike, all pass in simulation
    Roadmap step 4. run_arch_tests.py runs riscv-arch-test 3.9.1 through
    RISCOF, with Spike (--priv=m) as the reference, on Verilator models of the
    generated SDRAM and BRAM pipeline images, each with and without RVC. A stub
    ROM jumps straight to the preloaded image, so nothing goes through the UART
    loader. The finisher halt resets into the stub, which stores a marker, and
    the testbench then writes the signature from RAM.
    - SDRAM pipeline with RVC (the board image): 92/92. Without RVC: 63/63.
    - BRAM pipeline: 85/92 with RVC, 56/63 without. The seven missing tests are
    the branch and JAL tests, 226 KiB to 1.7 MiB images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
2026-10-19 SDRAM cache: 512x32 data banks fix write-update on the board
    Write-update failed on the board because Gowin maps the cache's deep data
    array to narrow BSRAM slices (8Kx2/16Kx1), and on this board a single-word
    write to those sometimes changes a bit of another word in the slice. A
    standalone probe (bsram-rdw/) shows it, independent of clock rate and of any
    concurrent read; the 512x32 mode is clean. The data array is now explicit
    512x32 banks; the cache logic is unchanged and cycle-identical.
    Board: the classifier passes 3/3 at 54 MHz/32 KiB and 72/54 MHz/64 KiB with
    write-update, 2,059,065 us against 2,836,998 (1.38x), so WRITE_UPDATE now
    defaults to 1. Adds a whole-netlist gate-level harnes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
2026-10-21 Split SimpleRisc and the Tang Nano 20K boards out of HaskPlayground
    History is filtered from HaskPlayground to the core, its SDRAM and PSRAM
    variants, the Clash runner, the reference model and tests, everything under
    boards/tangnano20k, the dated reports and their evidence, and the earlier
    RISC-V experiments that preceded SimpleRisc. New: simple-risc.cabal, a test
    entry point, README, trimmed .gitignore and docs index. The package name
    changes from haskplayground to simple-risc in the package-qualified test
    imports, the -hide-package flags of the board scripts and docs, and the
    arch-test runner.
2026-10-27 Add board identity and CRC-checked upload recovery protocol
2026-10-28 Benchmark cache options and reduce replacement-state FPGA area
    Add a frozen eight-case predictor/cache/bridge benchmark and replayable evidence. Replace the cache MRU register vector with distributed RAM, preserving replacement decisions and classifier cycle counts while reducing routed logic usage by 18.79%.
    Add replacement-policy and benchmark guard checks to CI, synthesized RAM model support, and detailed control-fanout and area analysis with physical validation and restoration receipts.
2026-10-28 Split pipeline stage tokens from payloads so payloads load under local stage enables
    D, E1, E2 and M become Slot {valid, payload}. Handover, FENCE.I, redirects
    and resets clear only the validity token; each payload loads from the stage
    before it under that stage's own advance decision (registered state only)
    and otherwise holds, so the payload flip-flops can use clock enables instead
    of next-state muxes driven by the cancellation logic. Observable behaviour is
    unchanged: all readers use the pD/pE1/pE2/pM views, which return Nothing for
    an invalid slot. Timing effect not yet measured with Gowin.
2026-10-28 ROM identity and CRC-verified upload record, SDRAM pipeline testbench extensions, CI and ignore updates
    Dated record for the boot-ROM board identity / I/U/C/G verified-upload
    protocol and the ERR HDR investigation; pipeline_cpu_tb.v and
    check_pipeline_rtl.py extensions; dependability roadmap corrections for
    priorities 1-2; CI workflow update; ignore .qwen/; internal NOTES.txt.
2026-10-29 Give each pipeline stage its own enable register; make a hold a clock enable
    Item 1 and the safe half of item 3 of the independent timing review. Stage
    payloads (D, E1, E2, M) and the pipeline field now live in their own
    clock-enabled registers beside Machine, injected before the step and taken
    back from it like cpuRfA/cpuRfB. StageLoad carries the four per-stage enables;
    they are supersets of "this payload changes" because an empty stage takes a
    new instruction even when it cannot advance.
    SdramPipeline.step no longer selects the whole Machine on `held`. HeldState
    (cycle counter, mtime and the received-byte holding register) registers every
    cycle, the rest of the machine loads under enable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
2026-10-29 Record the 48 MHz board run of the per-stage enable build
    The placement-3 bitstream (SHA-256 a78ee650...) was programmed into FPGA SRAM
    and the board's own scripts were run against it: the 1 MiB working-set core
    check, 38,400 RV32I and 30,720 RV32M reference checks, 3,852 bus checks, the
    finisher cases, 90 traps, 31 exception checks, five exact C arithmetic runs
    with UART and Ctrl-C recovery, 27 counter checks over ten runs and 27
    interrupt checks over five runs. All pass, so interrupts and Ctrl-C during
    cache misses, exact retirement and the full 8 MiB map are exercised on
    hardware with the new register structure.
    The framed U upload still answers ERR HDR, reproducing the recorded board
    re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
2026-10-29 Split SimpleRisc.hs into Types, Decode and Uart modules
    The value-level and type-level dependency graphs of SimpleRisc.hs are both
    acyclic: 206 bindings reduce to 206 singleton components, and none of the 44
    type declarations depends on Machine. So the file splits without inventing an
    interface: types go below every behaviour module, and SimpleRisc re-exports its
    submodules so test/SimpleRisc.hs and the SDRAM wrappers are unchanged.
    SimpleRisc.Types holds the 44 declarations and the four DataReprAnn blocks for
    CpuPhase, MemoryTarget, BusPhase and CommitKind. SimpleRisc.Decode holds
    instruction decode, the ALU candidates, compute, the multiply/divide step, the
    memory-map constants and the la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
2026-10-29 Take the replacement bit out of distributed RAM and shorten the hold enable
    Two changes to the two path groups the last measurement put on top.
    The replacement bit now lives in block RAM like the tags, with the
    write-through for a write that lands on the address being read carried in
    registers one cycle later, so the memory's read-during-write result is never
    observed. That removes the design's worst path (cpu_address -> entry_mru,
    25.2 ns) from the leading set entirely, and costs one BSRAM and two flops.
    The hold enable now starts at a register and nothing else. breaking reads
    cpuInRom from the machine register instead of from the assembled pipeline,
    and the stage payload registers load o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
2026-10-29 Push the clock: two build options take the same netlist to 74.5 MHz
    Neither change is in the RTL. The processor is routing and mapping dominated
    and the stock effort stops early:
    54.863 MHz stock (-route_option 0 -map_option 1)
    63.401 MHz -route_option 1
    74.483 MHz -route_option 1 -map_option 3
    -route_option 1 looks harder for a routing solution; -map_option 3 lets
    synthesis grow the LUT count for a LUT5-oriented mapping, which costs 13% more
    logic and buys 11 MHz because the depth is a chain of narrow LUTs rather than
    one wide function. -map_option 4 reaches 99% logic and the placer fails with
    nine SSRAMs unplaced. SDRAM_TARGET_MHZ=53 and SDRAM_PLACE_OPTION=4 produce
    builds ident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
2026-10-29 Attack the hold enable: route_maxfan helps, freeing the payloads does not
    Two attempts at the ~3,900-flop net that every leading path still goes
    through.
    Freeing the D/E1/E2 payload registers from the hold enable looked safe:
    each one's next value is idempotent across held cycles, so loading it every
    cycle instead of only on ~holding should reload the same value. It is not
    safe, and the RTL guest caught it (timeout after 22 fills, hold=x reaching
    the cache). A payload register runs one stage ahead of its own token: while
    the pipeline is held, e2Advance is frozen true, so a free-running E2 payload
    is overwritten with e1Out(E1) -- the instruction behind it -- while the pipe
    register carrying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
2026-10-29 Register the branch table update, and find the enable's real depth
    The last note claimed the wall was fan-out. The netlist disagrees: the tool has
    already split the enable into 172 CE nets (widest 641 loads) and the leading
    paths end at a *forty-one* load net. What those paths contain is logic. The
    worst one ran
    ds5_732 -> case tree -> thirteen-bit carry chain -> two LUTs -> CE
    7.6 ns to 22.8 ns, of which the buffer tree is only the last 3 ns. ds5[768:770]
    is e1Pc[4:2] and btbIndex pc = pc >> 2, so synthesis had absorbed the branch
    table's entry select -- and the whole branch-target adder behind it -- into the
    clock enable of the pipe register.
    So Pipe gains pBtbWrite :: Maybe (Index 8,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
2026-10-29 Structural measurement programme: observations, BTB banks, queue/effect contracts
    - Named simulation observation top (SdramPipelineObserved); testbenches and
    profiling no longer depend on packed Machine/Pipe bit offsets.
    - Host-only pipeline-layout metadata (tools/PipelineLayout.hs) and width-checked
    D/CE path attribution in analyze_implementation.py.
    - Startup fix: align _bss_start inside the SDRAM RAM section (unaligned BSS
    clear trapped before main and printed only DONE).
    - Diagnostic readback ROM (ROM_DIAGNOSTIC_READBACK) and output diagnostics;
    the 60 MHz cold-fill failure is read capture, fixed by 112.5 degree phase.
    - BTB storage as eight separately enabled banks with register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
2026-10-29 Attribute every classifier cycle to one issue-slot cause
    PipelineTrace gains ptSlot and ptFetchPortBlocked behind
    -DPIPELINE_SLOT_OBSERVATIONS, so the ordinary board RTL stays
    code-identical to the accepted BTB-only build. SdramPipelineObserved
    exports them as observe_slot/observe_fetch_port_blocked under the flag;
    perf_tb.v counts them; run_perf.py --stall-breakdown (named-v2 ABI)
    checks that causes plus held cycles equal the window and prints the table.
    Frozen classifier at 48/48 MHz: IPC 0.272; mispredicts (restart, refill,
    wrong path) 33.5% of cycles, decode operand hazards 24.4%, load waits
    6.8%, cache holds 5.8%. All 20 shared counters match the BTB-only receipt.
    Report docs/2026-10-3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
2026-10-30 Split hazards by producer and redirects by kind; replay the predictor
    Simulation-only observations (behind -DPIPELINE_SLOT_OBSERVATIONS) name
    the producer behind each decode hazard and the kind of each redirect.
    run_perf --split checks both partitions; --control-trace writes committed
    control flow for predictor_replay.py, whose model of the BTB matches the
    core per instruction. Board RTL is unchanged.
2026-10-30 Return stack, straddling-branch install and assembly-stage correction
    - Train straddling 32-bit branches and jumps into the BTB, keyed on their
    second word at slot 0.
    - 8-deep return address stack (compressed mode): speculative stack updated
    as instructions leave A, restored from an in-order copy on restart.
    Returns are no longer trained into the BTB.
    - A corrects a return or JAL whose prediction is wrong and steers fetch
    next cycle, discarding only fetch, the word queue and A. The decision
    reads raw bits; the target has its own register (pFrontTarget).
    - Observation of front redirects, control trace, predictor replay
    variants, and properties for compressed control flow and the r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
2026-10-30 BTB: 64 entries in an asynchronously read RAM
    Index pc[7:2], tag pc[15:8]. btbStorage keeps slot, tag and target in a
    64 x 41 RAM read at the registered fetch pc's index, with valid bits in
    flip-flops cleared by reset. The core reads one entry (stored, or the
    pending write's for the same index), so the board feeds that entry into
    every pBtb slot and no 64-way mux is built. Gowin maps the table to two
    block RAMs, absorbing the next fetch pc into the read address.
    Classifier: 1.069x fewer cycles than 8 entries (IPC 0.342); 60 MHz passes
    at placements 0, 2 and 3.
2026-10-31 Path census at 96 MHz and the frequency plan
    - docs: a measurement plan for what holds the clock back, and the first
    census: all 3,000 setup paths of a CPU-96/SDRAM-48 build mapped to
    pipeline fields. Six structures fail at 75-78 MHz (front end, execute,
    the cpuFast pipeline/multi-cycle select, the cache hold enable through
    cpuInRom, the multiplier chain, the cache way select). A what-if build
    with the two control fan-outs cut reaches 79.7 MHz with 10 endpoints
    failing at 84.
    - build.sh: SDRAM_REPORT_PATHS (full setup report, larger fan-out and
    congestion tables), SDRAM_CRITICAL_PATHS, and SDRAM_EXTRA_SDC for
    what-if constraints (labelled as not a board image).
    - path_census.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
2026-11-01 fprisc-72 preset: CPU 72 / SDRAM 48 MHz
    SDRAM_PRESET=fprisc-72 pins the image that passed FP-RISC's whole Tang
    Nano suite on the board: CPU 72 MHz behind the clock bridge, SDRAM 48 MHz,
    two-way 64 KiB cache, 135 degrees, placement 0 aimed at 79 MHz with map 3,
    route 1 and route fan-out 8 (74.6 MHz, +0.488 ns). preset_manifest.py
    records each preset's configuration and ROM identity and runs the timing
    gate at both clocks; fprisc-48 is unchanged. Both presets refuse what-if
    constraints.
    The record compares the classifier with earlier weeks: the same 20 October
    binary runs 1.23x faster than on the rejected 72/54 image, and correctly;
    today's FP-RISC build is 1.19x slower than that binary on th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
2026-11-03 CPU 81 MHz with E2->D forwarding: fprisc-81 preset, board-passing
    - Core: E2 results with a ready value (link, LUI, AUIPC, ALU) forward to
    decode's operand mux; decodeHazard no longer stalls on them. The
    multiply combine is pipelined over two M cycles (mSum). D.fPc no longer
    feeds the hazard check.
    - Cache: the way-1 hit no longer waits on way 0's match, and the
    non-BSRAM overrides resolve in parallel so the late BSRAM outputs pass
    one byte-lane mux.
    - Build: 81 MHz allowed by the clock guards; the split-clock SDC carries
    setup-2/hold-1 multicycle constraints across the bridge.
    - fprisc-81 preset (CPU 81 / SDRAM 48, fprisc-72 shape) at placement 1:
    with forwarding, placement 3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
2026-11-04 Shifts complete in E1 and forward from E2
    Shifts were the largest hazard producer left after E2->D forwarding
    (10.4% of classifier cycles): E1 did two levels, M finished the high three
    at commit, and decode stalled through all three stages. E1 now shifts by
    all five amount bits from its registered operands, so shifts forward from
    E2 like any ALU result; mShift, mArith, mAmount and e2ShiftFast are gone.
    - Priced in simulation: forwarding from M 1.024x, the whole shift in E1
    1.041x (IPC 0.382 -> 0.397); the second is taken.
    - fprisc-81 preset closes at 82.651 MHz (+0.247 ns, was +0.036 ns).
    - Board at 81 MHz: processor, RV32M (30,720) and RV32I (38,400) checks
    and the FP-RISC suite (7/7)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
2026-11-06 Area census, generated floorplans and the IPC plan at 81 MHz
    Where the core's logic goes and where it was placed: about 40% of the
    core's 12,461 LUT4 equivalents is machine state outside the pipeline
    (CSRs, traps, counters, bus, devices, the divide unit), it sits in the
    middle of the die, and routing is 78% of delay over 3,000 reported paths.
    - area_census.py: LUTs by the register they feed, from the synthesized
    netlist; pipeline-layout also prints the Machine record for it.
    - floorplan_cst.py: GROUP/GRP_LOC region constraints from a plan over the
    census's field names, in the syntax the 2026-11-05 trial got wrong
    (R[m:n]C[k:t]); `free` leaves registers one LUT cone from the pipeline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
2026-11-06 Three-clock cache port, adopted with a generated floorplan
    The cache's CPU port answers in three logical clocks again: cpu_rdata is
    the word selected after the BSRAM read, without the register that
    repeated it since 2026-10-29. inflightArrival is 2 for every memory and a
    load waits two cycles in the commit stage instead of three.
    It places because fprisc-81 now builds with a floorplan. build.sh runs
    synthesis, generates region constraints from the synthesized netlist with
    floorplan_cst.py (fprisc-81.plan: CSR/trap/counter registers to the top
    band, bus and device registers to the bottom-left corner, registers one
    LUT cone from the pipeline left free), then places and routes at
    placement 3.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
2026-11-07 Refactor proposal, three bounded trials, and the long path census in pnr_only
    The 2026-11-07 architectural refactor plan (state ownership, registered
    service boundary, reset, DSP, explicit board composition) and the records
    of its first experiments, all measured against dcd220d with identical ROM
    bytes and regenerated floorplans:
    - division-only service port: -336 core LUT4 equivalents; the helper and
    two properties (dispatch of all eight M opcodes, division results and
    latency) stay in the tree, the call site stays on mulDivStep;
    - E1 payload reset removal, with a warm-reset equivalence bench
    (check_pipeline_reset.py, pipeline_reset_tb.v);
    - combined payload reset with three floorpla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
2026-11-08 The core without RVC: five placements pass 81 MHz with margin
    SDRAM_RVC=0 with the fprisc-81 settings and floorplan, from the canon's
    source: whole-design logic 15,074 -> 12,684 (-15.9%), occupied slices
    8,717 -> 8,053, and every placement option closes 81 MHz (88.149 MHz
    +1.001 ns at placement 3, 84.413, 85.238, 85.238, 82.194 at the others),
    routing in under a minute where the canon takes 3 to 46 minutes and fails
    at two of five. The IM observed core passes the cache/CDC guest, and the
    placement-3 image passes the processor, RV32M and RV32I checks on the
    board at 81 MHz (canon image restored afterwards).
    The cost is instruction fetch: the classifier is +25.8% text as RV32IM
    and needs +7.5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
2026-11-08 fprisc-81 is the RV32IM core
    The preset drops compressed instructions (SDRAM_RVC=0; fprisc-48 and
    fprisc-72 stay RV32IMC), the manifest records compressed=False and the
    ROM identity rv32im. Built from this tree: 88.149 MHz, +1.001 ns at
    placement 3, and every placement option closes 81 MHz (the IMC core
    closed two of four); occupied slices 8,053 against 8,717.
    Board at 81 MHz: processor, RV32M (30,720) and RV32I (38,400) checks and
    the FP-RISC suite (7/7, fprisc 5a6140c's runner on the 9451dca compiler)
    pass; the 512/128 classifier takes 7.278 s against the IMC canon's
    6.799 s, the 7% the simulation priced. A clock sweep of the IM netlist
    closes every placement at 84 MHz and two of four at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
2026-11-08 fprisc-84: the RV32IM canon at 84 MHz
    The fprisc-81 shape (RV32IM core, two-way 64 KiB cache, placement 3, the
    fprisc-81.plan floorplan) at CPU 84 MHz with the placer target at 92, the
    highest clock the sweep closed at every placement option. Built from this
    tree: 86.021 MHz, +0.280 ns, occupied slices 8,053, manifest ready.
    Board at 84 MHz: processor, RV32M (30,720) and RV32I (38,400) checks and
    the FP-RISC suite (7/7, fprisc 0e13f68's runner on the 9451dca compiler)
    pass; the 512/128 classifier takes 7.128 s against 7.278 s at 81 MHz and
    the IMC canon's 6.799 s. The SDRAM README's preset guide now lists the
    RV32IM presets.
2026-11-08 Amended proposal: structure, not ownership, and the plan for 87 MHz
    Restates the refactor's objective after two days of measurement: the unit
    of progress is occupied slices and the wire length of the loops that set
    the clock, judged as four of four placements closing; separation of state,
    service interfaces and DSP implementations earn their place only when they
    remove slices or shorten a loop. Keeps the revised acceptance method,
    division-only dispatch, the A-to-F patch and the benches; drops payload
    reset separation, register-group floorplans and the fabric-heavy DSP
    counters; defers the service boundary and a narrower RVC front end.
    For 87 MHz the IM canon misses by 0.039 and 0.003 ns on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
2026-11-09 Equalities as LUT trees: step 1 of the amended proposal, measured and withdrawn
    The BTB tag, hazard register-index and cache MRU compares spelled as
    &(~(a ^ b)) remove their carry chains (443 to 400 mode-3 ALU cells) and
    every placement then misses 87 MHz by 0.26 to 1.68 ns, on those loops.
    A chain here is 0.549 ns plus 0.035 ns a cell with zero-delay carries,
    cheaper than any LUT tree up to 11 bits; Gowin re-infers ~|(a ^ b) as a
    chain. The source is unchanged; the page, the spelling experiment, the
    census, the nine routes and the RTL checks are the record.
